Driadix/ShuttleController/docs/ControllerV6/ControllerV6.kicad_pcb

## KiCad design docs/ControllerV6/ControllerV6.kicad_pcb (2026-07-10)

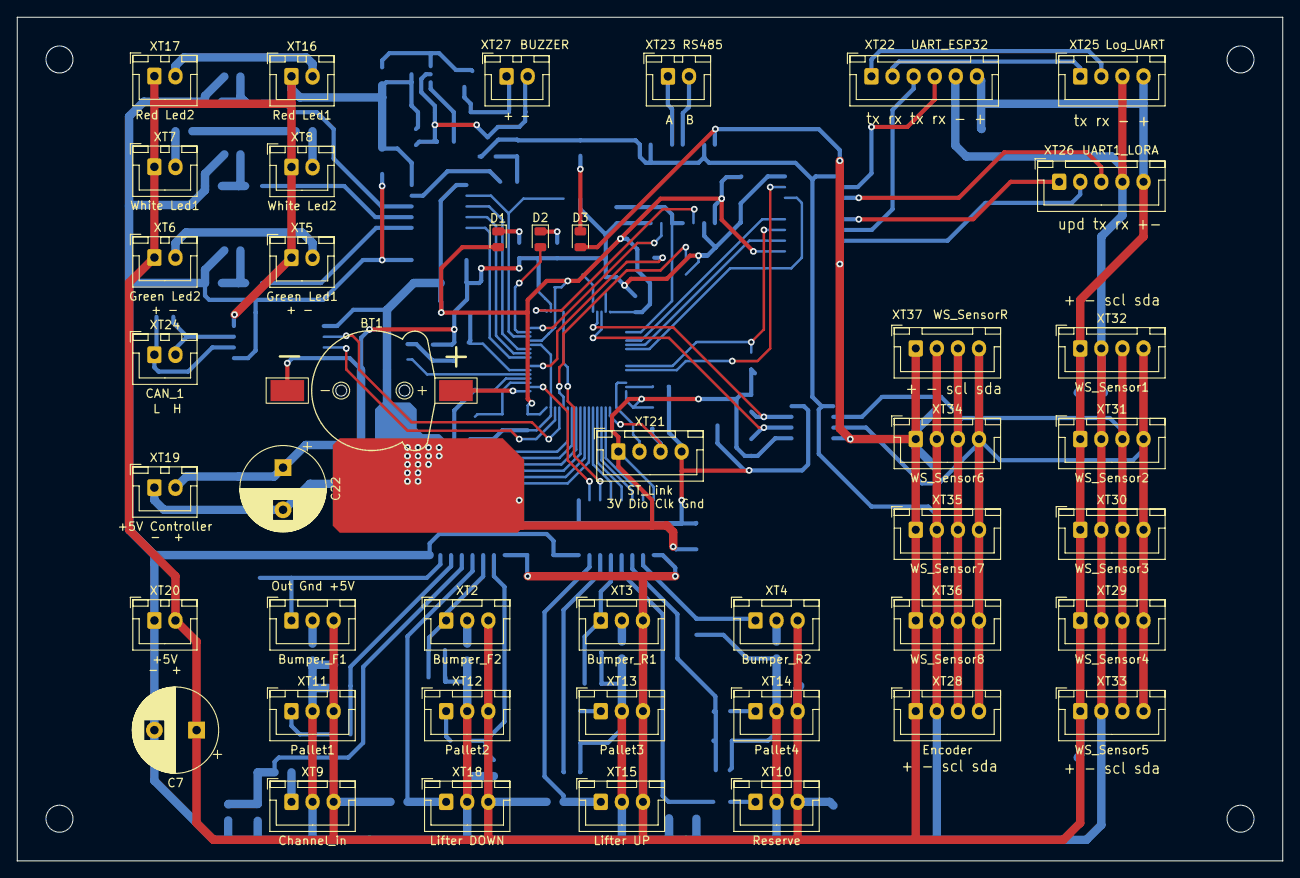
[picture p1: board ControllerV6.kicad_pcb from above]

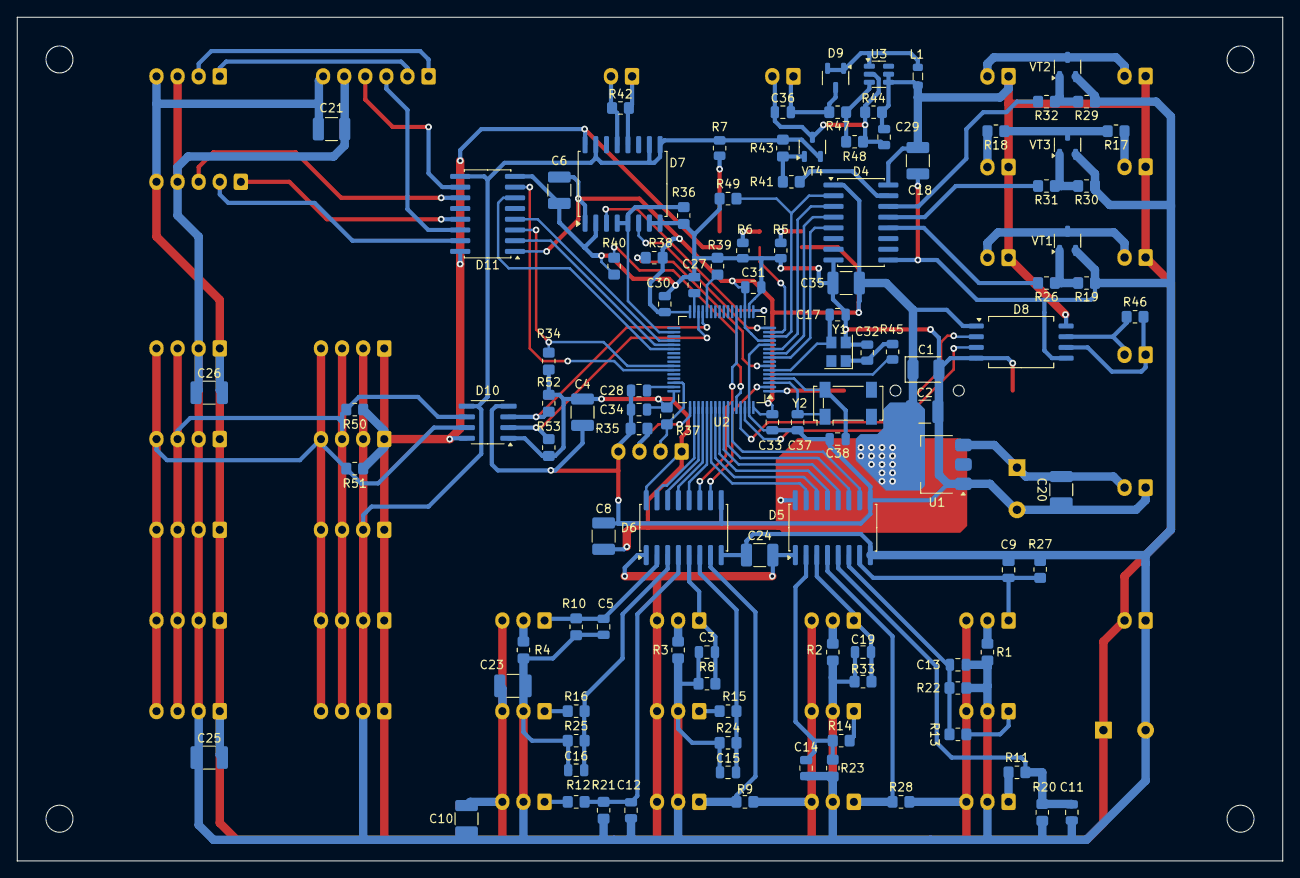
[picture p2: board ControllerV6.kicad_pcb from below]

Board: 2 copper layers, 150.0 x 100.0 mm, 150 parts (107 on the bottom side), 102 nets.

Parts:
BT1: +3V; BatteryHolder_RUICHI_856_CR1220
C1: 47u; CP_EIA-3528-21_Kemet-B
C2, C4, C6, C8, C10, C17, C18, C20, C21, C23, C24, C25, C26: 22u; C_1210_3225Metric_Pad1.33x2.70mm_HandSolder
C3, C5, C9, C11, C12, C13, C14, C15, C16, C19, C30, C31, C33, C34: 100n; C_0805_2012Metric
C7, C22: 100u; CP_Radial_D10.0mm_P5.00mm
C27, C28, C29, C36: 2.2u; C_0805_2012Metric
C32, C35: 18pF; C_0805_2012Metric
C37, C38: 12pF; C_0805_2012Metric
D1, D3: LED_VDD; LED_0805_2012Metric
D2: LED_USER; LED_0805_2012Metric
D4, D11: CA-IS3762; SOIC-16W_5.3x10.2mm_P1.27mm
D5, D6: CA-IS3760; SOIC-16W_5.3x10.2mm_P1.27mm
D7: CA-IS3082; SOIC-16W_7.5x10.3mm_P1.27mm
D8: CA-IS3050G; SOIC-8_7.5x5.85mm_P1.27mm
D9: BAT54CW; SOT-23-3
D10: CA-IS3020S; SOIC-8_3.9x4.9mm_P1.27mm
L1: 4.7U; L_0805_2012Metric
R1, R2, R3, R4, R17, R18: 200; R_0805_2012Metric_Pad1.20x1.40mm_HandSolder
R5, R6, R7: 1.2K; R_0805_2012Metric
R8, R10, R27, R33, R34, R44, R47: 20k; R_0805_2012Metric_Pad1.20x1.40mm_HandSolder
R9, R28, R35, R36, R37, R38, R39, R40, R49, R52, R53: 6.8k; R_0805_2012Metric_Pad1.20x1.40mm_HandSolder
R11, R12, R13, R14, R15, R16: 1k; R_0805_2012Metric_Pad1.20x1.40mm_HandSolder
R19, R29, R30, R43: 360; R_0805_2012Metric_Pad1.20x1.40mm_HandSolder
R20, R21, R22, R23, R24, R25, R50, R51: 3k; R_0805_2012Metric_Pad1.20x1.40mm_HandSolder
R26, R31, R32, R41: 1.2k; R_0805_2012Metric_Pad1.20x1.40mm_HandSolder
R42, R46: 120; R_0805_2012Metric_Pad1.20x1.40mm_HandSolder
R45: 360; R_0805_2012Metric
R48: 1.5k; R_0805_2012Metric_Pad1.20x1.40mm_HandSolder
U1: AMS1117-3.3; SOT-223-3_TabPin2
U2: STM32F405RGTx; LQFP-64_10x10mm_P0.5mm
U3: MT3608; SOT-23-6
VT1, VT2, VT3, VT4: BC817; SOT-23-3
XT1: Bumper_F1; JST_XH_B3B-XH-A_1x03_P2.50mm_Vertical
XT2: Bumper_F2; JST_XH_B3B-XH-A_1x03_P2.50mm_Vertical
XT3: Bumper_R1; JST_XH_B3B-XH-A_1x03_P2.50mm_Vertical
XT4: Bumper_R2; JST_XH_B3B-XH-A_1x03_P2.50mm_Vertical
XT5: Green Led1; JST_XH_B2B-XH-A_1x02_P2.50mm_Vertical
XT6: Green Led2; JST_XH_B2B-XH-A_1x02_P2.50mm_Vertical
XT7: White Led1; JST_XH_B2B-XH-A_1x02_P2.50mm_Vertical
XT8: White Led2; JST_XH_B2B-XH-A_1x02_P2.50mm_Vertical
XT9: Channel_in; JST_XH_B3B-XH-A_1x03_P2.50mm_Vertical
XT10: Reserve; JST_XH_B3B-XH-A_1x03_P2.50mm_Vertical
XT11: Pallet1; JST_XH_B3B-XH-A_1x03_P2.50mm_Vertical
XT12: Pallet2; JST_XH_B3B-XH-A_1x03_P2.50mm_Vertical
XT13: Pallet3; JST_XH_B3B-XH-A_1x03_P2.50mm_Vertical
XT14: Pallet4; JST_XH_B3B-XH-A_1x03_P2.50mm_Vertical
XT15: Lifter UP; JST_XH_B3B-XH-A_1x03_P2.50mm_Vertical
XT16: Red Led1; JST_XH_B2B-XH-A_1x02_P2.50mm_Vertical
XT17: Red Led2; JST_XH_B2B-XH-A_1x02_P2.50mm_Vertical
XT18: Lifter DOWN; JST_XH_B3B-XH-A_1x03_P2.50mm_Vertical
XT19: +5V Controller; JST_XH_B2B-XH-A_1x02_P2.50mm_Vertical
XT20: +5V; JST_XH_B2B-XH-A_1x02_P2.50mm_Vertical
XT21: ST_Link; JST_XH_B4B-XH-A_1x04_P2.50mm_Vertical
XT22: UART_ESP32; JST_XH_B6B-XH-A_1x06_P2.50mm_Vertical
XT23: RS485; JST_XH_B2B-XH-A_1x02_P2.50mm_Vertical
XT24: CAN_1; JST_XH_B2B-XH-A_1x02_P2.50mm_Vertical
XT25: Log_UART; JST_XH_B4B-XH-A_1x04_P2.50mm_Vertical
XT26: UART1_LORA; JST_XH_B5B-XH-A_1x05_P2.50mm_Vertical
XT27: BUZZER; JST_XH_B2B-XH-A_1x02_P2.50mm_Vertical
XT28: Encoder; JST_XH_B4B-XH-A_1x04_P2.50mm_Vertical
XT29: WS_Sensor4; JST_XH_B4B-XH-A_1x04_P2.50mm_Vertical
XT30: WS_Sensor3; JST_XH_B4B-XH-A_1x04_P2.50mm_Vertical
XT31: WS_Sensor2; JST_XH_B4B-XH-A_1x04_P2.50mm_Vertical
XT32: WS_Sensor1; JST_XH_B4B-XH-A_1x04_P2.50mm_Vertical
XT33: WS_Sensor5; JST_XH_B4B-XH-A_1x04_P2.50mm_Vertical
XT34: WS_Sensor6; JST_XH_B4B-XH-A_1x04_P2.50mm_Vertical
XT35: WS_Sensor7; JST_XH_B4B-XH-A_1x04_P2.50mm_Vertical
XT36: WS_Sensor8; JST_XH_B4B-XH-A_1x04_P2.50mm_Vertical
XT37: WS_SensorR; JST_XH_B4B-XH-A_1x04_P2.50mm_Vertical
Y1: 8MHz; Crystal_SMD_3225-4Pin_3.2x2.5mm
Y2: 32.7KHz; Crystal_SMD_Abracon_ABS25-4Pin_8.0x3.8mm

Connections:
3.3V_1: C1.1, C2.2, C4.2, C6.2, C8.2, C17.2, C30.2, C31.2, C33.2, C34.2, D1.2 (A), D4.1 (VDA), D5.16 (VDDB), D6.16 (VDDB), D7.1 (VDDA), D8.1 (Vcc1), D10.1 (VDDA), D11.1 (VDA), R34.2, R37.1, R38.1, R52.2, R53.2, U1.2 (VO), U2.13 (VDDA), U2.19 (VDD), U2.32 (VDD), U2.48 (VDD), U2.64 (VDD), XT21.1
5V: C7.1, C10.1, C18.1, C21.2, C23.2, C24.2, C25.2, C26.2, C29.2, D3.2 (A), D4.16 (VDDB), D5.1 (VDA), D6.1 (VDA), D7.16 (VDDB), D8.8 (Vcc2), D10.8 (VDDB), D11.16 (VDDB), L1.1, R9.1, R28.2, R44.2, R50.2, R51.2, U3.4 (EN), U3.5 (IN), XT1.3, XT2.3, XT3.3, XT4.3, XT5.1, XT6.1, XT7.1, XT8.1, XT9.3, XT10.3, XT11.3, XT12.3, XT13.3, XT14.3, XT15.3, XT16.1, XT17.1, XT18.3, XT20.2, XT22.6, XT25.4, XT26.5, XT28.1, XT29.1, XT30.1, XT31.1, XT32.1, XT33.1, XT34.1, XT35.1, XT36.1, XT37.1
5V_1: C20.2, C22.1, U1.3 (VI), XT19.2
Boot0_: R40.2, U2.60 (BOOT0)
Boot1: R39.2, U2.28 (PB2)
BumpF1_In: C9.2, D5.7 (VI6), R27.1, XT1.1
BumpF1_In_: D5.10 (VO6), U2.59 (PB7)
BumpF2_In: C19.2, D5.3 (VI2), R33.1, XT2.1
BumpF2_In_: D5.14 (VO2), U2.55 (PB3)
BumpR1_In: C3.2, D6.5 (VI4), R8.1, XT3.1
BumpR1_In_: D6.12 (VO4), U2.53 (PC12)
BumpR2_In: C5.2, D6.2 (VI1), R10.1, XT4.1
BumpR2_In_: D6.15 (VO1), U2.50 (PA15)
Buzzer: D4.15 (VO1), R41.1
Buzzer_: D4.2 (VI1), R49.2, U2.14 (PA0)
Can RX_: D8.2 (RXD), U2.61 (PB8)
Can TX_: D8.3 (TXD), U2.62 (PB9)
Can_H: D8.7 (CANH), R46.2, XT24.2
Can_L: D8.6 (CANL), R46.1, XT24.1
DI RS485: D7.6 (DI), U2.16 (PA2)
Esp32 RX: D11.10 (VI6), XT22.4
Esp32 RX_: D11.7 (VO6), U2.43 (PA10)
Esp32 TX: D11.14 (VO2), XT22.3
Esp32 TX_: D11.3 (VI2), R34.1, U2.42 (PA9)
GND: BT1.2 (-), C1.2, C2.1, C4.1, C6.1, C8.1, C17.1, C20.1, C22.2, C27.1, C28.1, C30.1, C31.1, C32.2, C33.1, C34.1, C35.2, C37.2, C38.2, D4.8 (GNDA), D5.9 (GNDB), D6.9 (GNDB), D7.2 (GNDA), D7.7 (GNDA), D7.8 (GNDA), D8.4 (GND1), D10.4 (GNDA), D11.8 (GNDA), R5.1, R6.1, R35.1, R36.1, R39.1, R40.1, R49.1, U1.1 (GND), U2.12 (VSSA), U2.18 (VSS), U2.63 (VSS), XT19.1, XT21.4, Y1.2, Y1.4
GNDREF: C3.1, C5.1, C7.2, C9.1, C10.2, C11.1, C12.1, C13.1, C14.1, C15.1, C16.1, C18.2, C19.1, C21.1, C23.1, C24.1, C25.1, C26.1, D4.9 (GNDB), D5.8 (GNDA), D6.8 (GNDA), D7.9 (GNDB), D7.10 (GNDB), D7.15 (GNDB), D8.5 (GND2), D10.5 (GNDB), D11.9 (GNDB), R1.1, R2.2, R3.1, R4.1, R7.1, R8.2, R10.2, R19.1, R20.2, R21.2, R22.2, R23.2, R24.2, R25.2, R27.2, R29.1, R30.1, R33.2, R43.2, VT1.2 (E), VT2.2 (E), VT3.2 (E), VT4.2 (E), XT9.2, XT10.2, XT11.2, XT12.2, XT13.2, XT14.2, XT15.2, XT18.2, XT20.1, XT22.5, XT25.3, XT26.4, XT28.2, XT29.2, XT30.2, XT31.2, XT32.2, XT33.2, XT34.2, XT35.2, XT36.2, XT37.2
Green Led: D4.12 (VO4), R26.2
Green Led_: D4.5 (VI4), U2.9 (PC1)
HSE1: R45.2, U2.5 (PH0)
HSE2: C35.1, U2.6 (PH1), Y1.3
In channel: C11.2, D5.5 (VI4), R11.2, R20.1
In channel_: D5.12 (VO4), U2.57 (PB5)
LSE1: C37.1, U2.3 (PC14), Y2.1
LSE2: C38.1, U2.4 (PC15), Y2.4
Led: D2.2 (A), U2.15 (PA1)
Lifter DOWN: D5.4 (VI3), R28.1, XT18.1
Lifter DOWN_: D5.13 (VO3), U2.56 (PB4)
Lifter UP: D6.7 (VI6), R9.2, XT15.1
Lifter UP_: D6.10 (VO6), U2.2 (PC13)
Lora_RX: D11.11 (VI5), XT26.3
Lora_RX_: D11.6 (VO5), U2.38 (PC7)
Lora_TX: D11.15 (VO1), XT26.2
Lora_TX_: D11.2 (VI1), U2.37 (PC6)
Lora_Upd: D11.13 (VO3), XT26.1
Lora_Upd_: D11.4 (VI3), U2.36 (PB15)
unnamed: C32.1, R45.1, Y1.1
unnamed: D1.1 (K), R5.2
unnamed: D2.1 (K), R6.2
unnamed: D3.1 (K), R7.2
unnamed: D7.12 (A), R42.2, XT23.1
unnamed: D7.13 (B), R42.1, XT23.2
unnamed: R47.1, R48.2, U3.3 (FB)
unnamed: C29.1, C36.1, R44.1, R48.1, U3.2 (GND), VT4.3 (C), XT27.2
unnamed: D9.1, D9.2, L1.2, U3.1 (SW)
unnamed: R19.2, R26.1, VT1.1 (B)
unnamed: VT1.3 (C), XT5.2, XT6.2
unnamed: R29.2, R32.1, VT2.1 (B)
unnamed: VT2.3 (C), XT16.2, XT17.2
unnamed: R30.2, R31.1, VT3.1 (B)
unnamed: R17.2, R18.1, VT3.3 (C)
unnamed: R41.2, R43.1, VT4.1 (B)
unnamed: R1.2, XT1.2
unnamed: R2.1, XT2.2
unnamed: R3.2, XT3.2
unnamed: R4.2, XT4.2
unnamed: R17.1, XT7.2
unnamed: R18.2, XT8.2
unnamed: R11.1, XT9.1
unnamed: R12.1, XT10.1
unnamed: R13.1, XT11.1
unnamed: R14.1, XT12.1
unnamed: R15.1, XT13.1
unnamed: R16.2, XT14.1
unnamed: XT22.1, XT25.2
unnamed: XT22.2, XT25.1
unnamed: C36.2, D9.3, R47.2, XT27.1
Pallet1: C13.2, D5.6 (VI5), R13.2, R22.1
Pallet1_: D5.11 (VO5), U2.58 (PB6)
Pallet2: C14.2, D5.2 (VI1), R14.2, R23.1
Pallet2_: D5.15 (VO1), U2.54 (PD2)
Pallet3: C15.2, D6.6 (VI5), R15.2, R24.1
Pallet3_: D6.11 (VO5), U2.21 (PA5)
Pallet4: C16.2, D6.3 (VI2), R16.1, R25.1
Pallet4_: D6.14 (VO2), U2.51 (PC10)
RE RS485: D7.4 (RE), D7.5 (DE), R36.2, U2.34 (PB13)
RO RS485: D7.3 (RO), U2.17 (PA3)
Red Led: D4.14 (VO2), R32.2
Red Led_: D4.3 (VI2), U2.11 (PC3)
Reserve: C12.2, D6.4 (VI3), R12.2, R21.1
Reserve_: D6.13 (VO3), U2.52 (PC11)
Reset_: R38.2, U2.7 (NRST)
SCL: D10.6 (SCLB), R50.1, XT28.3, XT29.3, XT30.3, XT31.3, XT32.3, XT33.3, XT34.3, XT35.3, XT36.3, XT37.3
SCL_: D10.3 (SCLA), R52.1, U2.29 (PB10)
SDA: D10.7 (SDAB), R51.1, XT28.4, XT29.4, XT30.4, XT31.4, XT32.4, XT33.4, XT34.4, XT35.4, XT36.4, XT37.4
SDA_: D10.2 (SDAA), R53.1, U2.30 (PB11)
SWCLK: R35.2, U2.49 (PA14), XT21.3
SWDIO: R37.2, U2.46 (PA13), XT21.2
VCAP_1: C27.2, U2.31 (VCAP_1)
VCAP_2: C28.2, U2.47 (VCAP_2)
Vbat: BT1.1 (+), U2.1 (VBAT)
White Led: D4.13 (VO3), R31.2
White Led_: D4.4 (VI3), U2.10 (PC2)
