Driadix/ShuttleController/Cntrl_V2/Cntrl_V2.ino

#include "As5600Sensor.h"
#include "AlertManager.h"
#include "BmsDdA5FirmwareAdapter.hpp"
#include "E22Radio.hpp"
#include "STM32TimerInterrupt.h"
#include "STM32_CAN.h"
#include "ShuttleProtocol.h"
#include "TOF_Sense.h"
#include "TofBusMonitor.h"
#include "TofHealthMonitor.h"
#include <IWatchdog.h>
#include <STM32RTC.h>
#include <String.h>
#include <Wire.h>

#pragma region Макросы...
#if defined(__GNUC__)
#pragma GCC diagnostic ignored "-Wunknown-pragmas"
#endif

#ifndef CONNECTION_LOGS
#define CONNECTION_LOGS 0
#endif

#ifndef I2C_DIAG_LOGS
#define I2C_DIAG_LOGS 0
#endif

constexpr size_t LOG_FORMAT_MAX_PRINTABLE_CHARS = 255;

enum BreadcrumbStage : uint8_t
{
    BC_BOOT = 1,
    BC_LOOP,
    BC_SYSTEM_YIELD,
    BC_BMS_TICK,
    BC_TX_TELEMETRY,
    BC_TX_SENSORS,
    BC_TX_STATS,
    BC_TX_LINK_HEALTH,
    BC_POLL_DISPLAY,
    BC_POLL_RADIO,
    BC_TOF_POLL,
    BC_TOF_PREFLIGHT,
    BC_TOF_PROBE,
    BC_TOF_READ,
    BC_TOF_RECOVERY,
    BC_AS5600_ANGLE,
    BC_SERIAL_COMMAND
};

#pragma pack(push, 1)
struct BreadcrumbRecord
{
    uint32_t magicWord;
    uint32_t sequence;
    uint32_t millisAt;
    uint8_t  stage;
    uint8_t  sensor;
    uint8_t  status;
    uint8_t  detail;
    uint16_t crc16;
    uint16_t reserved;
};
#pragma pack(pop)

#if CONNECTION_LOGS
#define DIAG_ONLY(code)                                                                                                     \
    do                                                                                                                      \
    {                                                                                                                       \
        code;                                                                                                               \
    } while (0)
#else
#define DIAG_ONLY(code)                                                                                                     \
    do                                                                                                                      \
    {                                                                                                                       \
    } while (0)
#endif

#define LOG_RATE_LIMITED(level, interval, format, ...)                                                                      \
    do                                                                                                                      \
    {                                                                                                                       \
        static_assert(                                                                                                      \
            sizeof(format) - 1 <= LOG_FORMAT_MAX_PRINTABLE_CHARS,                                                           \
            "Log format string too long for logStringBuffer.");                                                             \
        static uint32_t lastLog = 0;                                                                                        \
        if (millis() - lastLog > (interval))                                                                                \
        {                                                                                                                   \
            makeLogImpl(level, format, ##__VA_ARGS__);                                                                      \
            lastLog = millis();                                                                                             \
        }                                                                                                                   \
    } while (0)

#define makeLog(level, format, ...)                                                                                         \
    do                                                                                                                      \
    {                                                                                                                       \
        static_assert(                                                                                                      \
            sizeof(format) - 1 <= LOG_FORMAT_MAX_PRINTABLE_CHARS,                                                           \
            "makeLog: format string literal exceeds logStringBuffer capacity.");                                             \
        makeLogImpl(level, format, ##__VA_ARGS__);                                                                          \
    } while (0)

#define makeReliableLog(level, format, ...)                                                                                 \
    do                                                                                                                      \
    {                                                                                                                       \
        static_assert(                                                                                                      \
            sizeof(format) - 1 <= LOG_FORMAT_MAX_PRINTABLE_CHARS,                                                           \
            "makeReliableLog: format string literal exceeds logStringBuffer capacity.");                                     \
        makeReliableLogImpl(level, format, ##__VA_ARGS__);                                                                  \
    } while (0)

void                           makeLogImpl(LogLevel level, const char *format, ...);
void                           makeReliableLogImpl(LogLevel level, const char *format, ...);
void                           makeBootLog(LogLevel level, const char *format, ...);
static const char             *breadcrumbStageName(uint8_t stage);
static bool                    readBreadcrumb(BreadcrumbRecord *out);
static void                    writeBreadcrumb(BreadcrumbStage stage, uint8_t sensor = 0xFF, uint8_t status = 0, uint8_t detail = 0);
static void                    logPreviousBreadcrumbIfWatchdog(uint32_t resetFlags);
static void                    logBreadcrumbSummaryIfDue(uint32_t now);
static inline bool             isValidProvisionedShuttleId(int32_t id);
static inline bool             isProvisionedShuttle();
static inline bool             isSupportedCommand(uint8_t cmd);
static inline bool             isManualMoveCommand(uint8_t cmd);
static inline bool             isManualDistanceCommand(uint8_t cmd);
static inline bool             isContinuousManualCommand(uint8_t cmd);
static inline bool             isLiftCommand(uint8_t cmd);
static inline bool             isUnprovisionedCommandAllowed(uint8_t cmd);
static inline bool             isOutOfChannelExemptCommand(uint8_t cmd);
static inline bool             canAcceptCommandNow(uint8_t cmd, bool fromRadio);
static inline bool             canApplyConfigNow();
static inline bool             isPhysicallyStationary();
static inline void             performSystemReset();
static inline void             clearLatchedAlertsAndReturnToIdle(uint32_t now);
static inline void             resetTofDiagnostics();
static inline void             handlePendingCrash();
static void                    crashF1Irq();
static void                    crashF2Irq();
static void                    crashR1Irq();
static void                    crashR2Irq();
static void                    recordBootResetCause();
static void                    setResetRequestMarker(uint32_t flags);
static uint32_t                consumeResetRequestMarker();
static uint32_t                captureResetReasonFlags();
static const char             *primaryResetCategoryName(uint32_t flags);
static inline void             touchManualSession();
static inline void             beginManualRadioHold(uint32_t now);
static inline void             refreshManualRadioHoldWatchdog(uint32_t now);
static inline void             clearManualRadioHold();
static void                    scheduleBootloaderEntry();
static void                    enableBackupSramAccess(uint32_t readyTimeoutMs);
static bool                    consumeBootloaderResetRequest();
static void                    requestBootloaderResetEntry();
static void                    resetIntoBootloader();
static E22Radio::EnsureOptions makeRadioEnsureOptions();
static E22Radio::LogicalConfig makeRadioDesiredConfig(uint8_t nodeId);
static bool                    ensureRadioConfigNow(const char *reason);
enum class RadioTxAuxPolicy : uint8_t
{
    DropIfBusy,
    SendAfterTimeout
};
static void       reapplyRadioConfigForShuttleId(uint8_t newId, uint8_t previousId);
static inline int transportAvailableForWrite(Stream *port);
static size_t
writeTransportPayload(
    Stream *port,
    const uint8_t *buffer,
    uint16_t length,
    const E22Radio::FixedRoute *fixedRoute = NULL,
    RadioTxAuxPolicy auxPolicy = RadioTxAuxPolicy::DropIfBusy);
static ShuttleState predictTelemetryStateForAcceptedCommand(uint8_t cmd, bool fromRadio);
static void         populateTelemetryPacket(TelemetryPacket *pkt, int16_t shuttleStatusOverride = -1);
static void         sendAck(uint8_t seq, AckResult result, Stream *port, const E22Radio::FixedRoute *fixedRoute = NULL);
static void         sendTelemAck(
            uint8_t                     seq,
            AckResult                   result,
            Stream                     *port,
            int16_t                     shuttleStatusOverride = -1,
            const E22Radio::FixedRoute *fixedRoute            = NULL);
static void sendCommandAck(
    uint8_t   seq,
    AckResult result,
    Stream   *port,
    bool      suppressAck,
    bool      useTelemAck,
    int16_t   shuttleStatusOverride = -1);
static void                  sendTelemetryPacket(Stream *port);
static void                  sendSensorPacket(Stream *port);
static void                  sendStatsPacket(Stream *port);
static void                  sendLinkHealthPacket(Stream *port);
static void                  populateLinkHealthPacket(LinkHealthPacket *pkt);
static void                  sendAs5600HealthPacket(Stream *port);
static bool                  isRadioPacketRssiFresh(uint32_t now);
static BmsDdA5::ActivityHint mapBatteryActivity();
static void                  batterySafetyCheck(uint32_t now);
static void                  batterySafetyReset(uint32_t now);
static void                  stopTofI2cBus();
static void                  initTofI2cBus();
static bool                  performTofSdaClockRecovery(const char *reason);
static bool                  performTofSclReleaseRecovery(const char *reason);
static bool                  performTofWireReinit(const char *reason);
static bool                  recoverTofBusForManualClear();
static bool                  serviceTofBusMonitor(uint32_t now);
static inline bool           tofBusLinesHighNow();
static void                  resetTofBusVote();
static void                  beginTofSchedulerPause(uint32_t now);
static void                  endTofSchedulerPause(uint32_t now, const char *reason);
static void                  setTofI2cClock(uint32_t clockHz);
static uint8_t               i2cProbeAddress(uint8_t address);
static uint8_t               scanTofAddressMask();
static void                  logI2cBootScanAtClock(uint32_t clockHz);
static void                  logTofI2cLines(const char *tag);
static void                  logI2cBootScan();
static void                  logTofBootSnapshot();
static void                  logI2cDiagSummaryIfDue(uint32_t now);
static bool                  ensureAs5600BusReady(uint32_t now);
static void                  serviceAs5600Safety(uint32_t now);
static void                  logAs5600FailureIfDue(uint32_t now);
static void                  latchAs5600Fault(const char *context, uint8_t i2cStatus);
static void                  clearRecoveredAs5600FaultIfSafe(uint32_t now);
static bool                  readAs5600AngleForMotion(uint16_t *rawAngle);
static bool                  readAs5600AngleFresh(int *angleOut);
static void                  logBootResetReplay();
static void                  retryRadioConfigIfIdle(uint32_t now);
static inline bool           batteryIsHighLoad();
static inline bool           batteryLowFaultLatched();
static bool                  batteryIsMotionLikeStatus(uint8_t st);
static const char           *tofNameForSensor(uint8_t sensorIndex);
static uint8_t               tofSensorForDistanceSlot(uint8_t distanceSlot);
static void                  latchTofMeasurementFault(uint8_t sensor, uint32_t now, const char *context);
static bool                  ensureChannelTofReadyForMotion(bool forward, const char *context);
static void                  enforceActiveMotionTofSafety(uint32_t now);

static inline void preserveManualStopOnAbort();
static inline bool shouldAbortLoop();
static inline bool isErrorActive();
static inline bool isOverrideCommand(uint8_t cmd);
static inline void countTxFrame(Stream *port);
static inline void countReplyTiming(Stream *port, uint32_t elapsedUs);
static inline bool isShuttleIdle();

void motor_Stop();
void motor_Force_Stop();
void motor_Speed(int spd);
void moove_Before_Pallete_F();
void moove_Before_Pallete_R();
void stop_Before_Pallete_F();
void stop_Before_Pallete_R();
void moove_Distance_F(int dist, int maxSpeed, int minSpeed);
void moove_Distance_F(int dist);
void moove_Distance_R(int dist, int maxSpeed, int minSpeed);
void moove_Distance_R(int dist);
void moove_Forward();
void moove_Reverse();
void moove_Right();
void moove_Left();

// Operations
void lifter_Down();
void lifter_Up();
void lifter_Stop();
void load_Pallete();
void unload_Pallete();
void single_Load();
void long_Load();
void long_Unload();
void long_Unload(uint8_t num);
void pallete_Compacting_F();
void pallete_Compacting_R();
void pallete_Counting_F();
void demo_Mode();

// System
void run_Cmd();
void send_Cmd();
void get_Distance();
void detect_Pallete();
void set_Position();
void blink_Work();
void blink_Warning();
void blink_Error();
void jumpToBootloader();

#define STATS_MAGIC_WORD        0xAA55BEF0
#define BKPSRAM_BASE_ADDR       0x40024000
#define RESET_MARKER_MAGIC_WORD 0x51E7A5E7UL
#define RESET_MARKER_MAGIC_ADDR (BKPSRAM_BASE_ADDR + 0x0FE8)
#define RESET_MARKER_FLAGS_ADDR (BKPSRAM_BASE_ADDR + 0x0FEC)
#define BOOTLOADER_MAGIC_WORD 0xB00710ADUL
#define BOOTLOADER_MAGIC_ADDR (BKPSRAM_BASE_ADDR + 0x0FF0)
#define BOOTLOADER_MAGIC_CONFIRM_WORD 0x4FF8EF52UL
#define BOOTLOADER_MAGIC_CONFIRM_ADDR (BKPSRAM_BASE_ADDR + 0x0FF4)
#define DIAG_BREADCRUMB_MAGIC_WORD 0xBADC0DE5UL
#define DIAG_BREADCRUMB_OFFSET     0x0F80
#define DIAG_BREADCRUMB_ADDR       (BKPSRAM_BASE_ADDR + DIAG_BREADCRUMB_OFFSET)
#define DIAG_BREADCRUMB_MAX_AGE_MS 600000UL

#pragma pack(push, 1)
struct SecureStats
{
    uint32_t    magicWord;
    StatsPacket payload;
    uint16_t    crc16;
    uint16_t    reserved;
};
#pragma pack(pop)

static_assert(sizeof(SecureStats) <= DIAG_BREADCRUMB_OFFSET, "SecureStats overlaps diagnostic breadcrumb.");
static_assert(
    DIAG_BREADCRUMB_OFFSET + sizeof(BreadcrumbRecord) <= 0x0FE8,
    "Diagnostic breadcrumb overlaps reset markers.");

SecureStats *volatile sramStats = (SecureStats *)BKPSRAM_BASE_ADDR;
static volatile uint32_t *const resetMarkerMagic = (volatile uint32_t *)RESET_MARKER_MAGIC_ADDR;
static volatile uint32_t *const resetMarkerFlags = (volatile uint32_t *)RESET_MARKER_FLAGS_ADDR;
static volatile uint32_t *const bootloaderMagicWord = (volatile uint32_t *)BOOTLOADER_MAGIC_ADDR;
static volatile uint32_t *const bootloaderMagicConfirm = (volatile uint32_t *)BOOTLOADER_MAGIC_CONFIRM_ADDR;
static volatile BreadcrumbRecord *const diagBreadcrumb = (volatile BreadcrumbRecord *)DIAG_BREADCRUMB_ADDR;
static uint32_t breadcrumbSequence = 0;
static uint32_t lastBootResetFlags = RESET_REASON_UNKNOWN;
static uint32_t lastBootResetMarkerFlags = RESET_REASON_NONE;

ProtocolParser               parserRadio;
ProtocolParser               parserDisplay;
E22Radio::Radio              e22Radio;
constexpr E22Radio::UartBaud kRadioHostBaud = E22Radio::UartBaud::B57600;

#define STATS_ATOMIC_UPDATE(action)                                                                                         \
    do                                                                                                                      \
    {                                                                                                                       \
        __disable_irq();                                                                                                    \
        action;                                                                                                             \
        sramStats->crc16 = ProtocolUtils::calcCRC16((uint8_t *)&sramStats->payload, sizeof(StatsPacket));                   \
        __enable_irq();                                                                                                     \
    } while (0)

#define CONFIG_SECTOR      FLASH_SECTOR_7
#define CONFIG_SECTOR_BASE 0x08060000
#define CONFIG_SECTOR_SIZE (128 * 1024)
#define CONFIG_PAGE_SIZE   512
#define CONFIG_TOTAL_PAGES (CONFIG_SECTOR_SIZE / CONFIG_PAGE_SIZE)

struct ConfigPageHeader
{
    uint8_t  state;
    uint8_t  reserved[1];
    uint16_t crc16;
};
#define MEDIAN(a, b, c) ((a) + (b) + (c) - min(min(a, b), c) - max(max(a, b), c))

#pragma endregion

#pragma region Пины и дефайны...

#define DL_UP       PC13 // Пин датчика положения лифтера в поднятом состоянии
#define DL_DOWN     PB4  // Пин датчика положения лифтера в опущенном состоянии
#define DATCHIK_F1  PA5  // Пин датчика 1 обнаружения паллета вперед
#define DATCHIK_F2  PC4  // Пин датчика 2 обнаружения паллета вперед
#define DATCHIK_R1  PB6  // Пин датчика 1 обнаружения паллета назад
#define DATCHIK_R2  PD2  // Пин датчика 2 обнаружения паллета назад
#define GREEN_LED   PC1  // Пин зеленого светодиода
#define BOARD_LED   PA1  // Пин светодиода на плате
#define RED_LED     PC3  // Пин красного светодиода ошибки
#define WHITE_LED   PC2  // Пин белого светодиода работы
#define ZOOMER      PA0  // Зумер
#define RADIO_E22_M0  PB15
#define RADIO_E22_M1  PB14
#define RADIO_E22_AUX PC0
#define RS485       PB13 // Пин передачи шины RS485
#define BUMPER_F1   PB7  // Пин бампера вперед
#define BUMPER_F2   PB3  // Пин бампера вперед
#define BUMPER_R1   PC12  // Пин бампера назад
#define BUMPER_R2   PA15  // Пин бампера назад
#define CHANNEL     PB5  // Пин датчика канала
#define TOF_I2C_SDA PB11
#define TOF_I2C_SCL PB10

#define FLASH_SECTOR_SIZE  4 * 1024 // 16 kb
#define EEPROM_PAGE_SIZE   512
#define EEPROM_TOTAL_PAGES FLASH_SECTOR_SIZE / EEPROM_PAGE_SIZE
#define EEPROM_HEADER_SIZE 1
#define EEPROM_DATA_SIZE   EEPROM_PAGE_SIZE - EEPROM_HEADER_SIZE

#define SerialLora    Serial3
#define SerialRS485   Serial2
#define SerialDisplay Serial1

constexpr uint8_t  NO_NEW_CMD                  = 0xFF;
constexpr uint8_t  kFirmwareVersionMajor       = 2;
constexpr uint8_t  kFirmwareVersionMinor       = 0;
constexpr uint8_t  kFirmwareVersionPatch       = 7;
constexpr uint32_t kBootLogSettleMs            = 250;
constexpr uint32_t kBootLogWriteTimeoutMs      = 250;
constexpr uint32_t kManualSessionIdleTimeoutMs = 60000;
constexpr uint32_t kManualRadioHoldWatchdogMs  = 3000;
constexpr uint32_t tofI2cClockHz                = 100000U;
constexpr uint32_t kTofI2cSlowProbeClockHz      = 100000U;
constexpr uint32_t kTofI2cFastProbeClockHz      = 400000U;
constexpr uint32_t kTofI2cRecoveryMinIntervalMs      = 5000U;
constexpr uint32_t kTofLineLowConfirmMs               = 2U;
constexpr uint32_t kTofLineReleaseConfirmMs           = 2U;
constexpr uint32_t kTofFailureLogIntervalMs           = 5000U;
constexpr uint32_t kBmsTofQuietGuardMs                = 5U;
constexpr uint32_t kRadioPacketRssiFreshMs            = 10000UL;
constexpr uint32_t kLinkHealthPublishMs               = 5000UL;
constexpr uint32_t kRadioRuntimeAuxWaitMs             = 20UL;
constexpr uint32_t kRadioLinkSilenceProbeMs           = 15000UL;
constexpr uint32_t kRadioPresenceAuditIntervalMs      = 300000UL;
constexpr uint32_t kRadioProbeRxQuietMs               = 10000UL;
constexpr uint32_t kI2cDiagSummaryIntervalMs          = 30000UL;

#pragma endregion

#pragma region Переменные...

char logStringBuffer[256];

enum class CoreOpMode
{
    IDLE,
    AUTO_EXEC,
    MANUAL,
    ERROR
};
CoreOpMode currentMode                    = CoreOpMode::IDLE;
uint32_t   lastManualSessionActivityTime  = 0;
bool       pendingDisplayManualModeBypass = false;
bool       manualRadioHoldActive          = false;
bool       statusSourceRadio              = false;
bool       radioAppendedRssiEnabled       = false;
bool       radioConfigOk                  = false;
uint32_t   manualRadioHoldLastHeartbeatMs = 0;
bool       serialLinksStarted             = false;
enum class RadioLocalState : uint8_t
{
    Unverified = 0,
    Ready,
    NoResponse,
    AuxTimeout,
    BadResponse,
    ConfigError
};
E22Radio::EnsureResult radioLastEnsureResult = {};
RadioLocalState         radioLocalState       = RadioLocalState::Unverified;
bool                    radioModuleResponded  = false;
uint8_t                 radioFailureStreak    = 0;
uint32_t                radioLastRxFrameMs    = 0;
uint32_t                radioLastLocalProbeMs = 0;
uint32_t                radioLastConfirmedMs  = 0;
uint32_t                radioRetryDelayMs     = 5000UL;

HardwareSerial Serial1(PA10, PA9); // Порт для экранцика LilyGo
HardwareSerial Serial2(PA3, PA2);  // Порт под RS485 для BMS батареи
HardwareSerial Serial3(PC7, PC6);  // Порт Lora
static const E22Radio::ControlPins kRadioControlPins = { RADIO_E22_M0, RADIO_E22_M1, RADIO_E22_AUX };

STM32_CAN            Can1(CAN1, ALT, RX_SIZE_256, TX_SIZE_256); // CAN шина на пинах PB8 PB9
static CAN_message_t CAN_TX_msg;                                // Пакет данных CAN на передачу
static CAN_message_t CAN_RX_msg;                                // Пакет данных CAN на прием

STM32Timer ITimer0(TIM1); // Таймер для прерываний

STM32RTC &rtc = STM32RTC::getInstance(); // Часы реального времени

typedef union
{
    int     vint;
    uint8_t bint[4];
} cracked_int_t; // Структура конвертации типа float в массив байтов для отправки по CAN

typedef union
{
    float   v;
    uint8_t b[4];
} cracked_float_t; // Структура конвертации типа float в массив байтов для отправки по CAN

#pragma pack(push, 1)
struct EEPROMData // Структура данных параметров для сохранения а EEProm
{
    uint8_t  shuttleNum;
    uint8_t  calibrateEncoder_F[8];
    uint8_t  calibrateEncoder_R[8];
    uint8_t  calibrateSensor_F[3];
    uint8_t  calibrateSensor_R[3];
    int      blinkTime;
    uint16_t maxSpeed;
    uint16_t minSpeed;
    uint16_t interPalleteDistance;
    uint8_t  inverse;
    uint8_t  fifoLifo;
    int      lifter_Speed;
    uint32_t timingBudget;
    uint8_t  minBattCharge;
    uint16_t shuttleLength;
    int      waitTime;
    int8_t   mprOffset;
    uint8_t  TopLeftXF;
    uint8_t  TopLeftYF;
    uint8_t  BotRightXF;
    uint8_t  BotRightYF;
    uint8_t  TopLeftXR;
    uint8_t  TopLeftYR;
    uint8_t  BotRightXR;
    uint8_t  BotRightYR;
    int8_t   chnlOffset;
};
#pragma pack(pop)

EEPROMData eepromData;

volatile bool      pendingEepromSave       = false;
constexpr uint32_t kBootloaderEntryGraceMs = 15;
constexpr uint32_t kSystemBootloaderAddr   = 0x1FFF0000UL;
volatile bool      pendingBootloaderEntry  = false;
volatile bool      bootloaderStopDone      = false;
volatile uint32_t  bootloaderEntryAtMs     = 0;

AlertManager alertMan;

#if CONNECTION_LOGS
struct LinkDiagCounters
{
    uint32_t radioRxValid;
    uint32_t radioRxCrcFail;
    uint32_t radioRxDropTarget;
    uint32_t radioTxFrames;
    uint32_t radioReplyCount;
    uint32_t radioReplyUsSum;
    uint32_t radioReplyUsMax;
    uint32_t displayRxValid;
    uint32_t displayRxCrcFail;
    uint32_t displayRxDropTarget;
    uint32_t displayTxFrames;
    uint32_t displayReplyCount;
    uint32_t displayReplyUsSum;
    uint32_t displayReplyUsMax;
    uint32_t loopJitterMaxMs;
    uint32_t loopGapOver20Ms;
};

LinkDiagCounters linkDiag            = {};
uint32_t         linkDiagLastYieldMs = 0;
#endif

void setFault(ShuttleFault fault)
{
    alertMan.setFault(fault);
}

void setWarning(ShuttleWarning warn, uint32_t timeoutMs = 5000)
{
    alertMan.setWarning(warn, timeoutMs, millis());
}

void clearWarning(ShuttleWarning warn)
{
    alertMan.clearWarning(warn);
}

void clearAllWarnings()
{
    alertMan.clearAllWarnings();
}

uint8_t      status           = 0; // Командный статус
ShuttleState currentOperation = STATE_IDLE;
uint8_t      shuttleNum       = 0; // Номер шаттла -сохранять-
uint8_t      channel[1024];        // Массив канала
uint8_t      calibrateEncoder_F[8] = {
    40, 40, 40, 40, 40, 40, 40, 40
}; // Массив данных калибровки магнитного энкодера при движении вперед -сохранять-
uint8_t calibrateEncoder_R[8] = {
    40, 40, 40, 40, 40, 40, 40, 40
}; // Массив данных калибровки магнитного энкодера при движении вперед -сохранять-
uint8_t calibrateSensor_F[3] = { 100, 100, 100 }; // Массив калибровки канального сенсора расстояния вперед -сохранять-
uint8_t calibrateSensor_R[3] = { 100, 100, 100 }; // Массив калибровки канального сенсора расстояния назад -сохранять-

uint8_t  counter              = 0;        // Счетчик для красивых морганий в рабочем режиме
uint8_t  debuger              = 0;        // Счетчик для дебагера
uint8_t  sensorOff            = 0;        // Флаг отключения сенсоров в ручном режиме
uint8_t  lastPallete          = 0;        // Флаг позиции последнего паллета
uint8_t  minBattCharge        = 20;       // Минимальный заряд батареи
uint8_t  endOfChannel         = 0;        // Флаг концов канала
int      blinkTime            = 80;       // Время квантования красивых морганий -сохранять-
int      waitTime             = 15000;    // Время ожидания при выгрузке
int      count                = millis(); // Счетчик времени общего назначения
int      count2               = count;    // Счетчик времени общего назначения
int      countSensor          = count;    // Счетчик времени опроса датчиков
int      countMoove           = count;    // Счетчик времени обновления передачи скорости по Can шине
uint16_t speed                = 0;        // Скорость движения в канале в %
uint16_t maxSpeed             = 96;       // Максимальное значение скорости (от 0 до 100 %) -сохранять-
uint16_t minSpeed             = 3;        // Минимальное значение скорости (лаг для АЦП) -сохранять-
uint16_t oldSpeed             = 0;        // Запомненная cкорость движения в канале для плавного разгона и торможения
uint16_t distance[8]          = { 0 };    // Значения от сенсоров расстояния и датчиков положения
uint16_t palletePosition[16]  = { 0 };    // Массив расстояний до паллет в канале
uint16_t mooveDistance        = 0;    // Значение дистанции для перемещения шаттла по команде движения на заданное расстояние
uint16_t interPalleteDistance = 100;  // Значение дистанции между паллетами -сохранять-
uint16_t shuttleLength        = 1000; // Длинна шаттла (максимальная ширина паллета которые шаттл может перевозить)
uint8_t  detectPalleteF1;             // Флаг датчика обнаружения паллеты вперед 1
uint8_t  detectPalleteF2;             // Флаг датчика обнаружения паллеты вперед 2
uint8_t  detectPalleteR1;             // Флаг датчика обнаружения паллеты назад 1
uint8_t  detectPalleteR2;             // Флаг датчика обнаружения паллеты назад 2
uint8_t  palleteCount  = 0;           // Количество паллет
uint8_t  motorStart    = false;       // Флаг запуска двигателя движения
uint8_t  motorReverse  = 2;           // Флаг направления (0/1), 2 = остановлено
uint8_t  lifterUp      = 0;           // Флаг поднятой платформы
uint8_t  inverse       = 0;           // Флаг инверсии движения -сохранять-
uint8_t  longWork      = 0;           // Флаг продолжительной загрузки/выгрузки
uint8_t  reportCounter = 0;           // Счетчик паузы репортов в секундах
uint8_t  diffPallete   = 0;           // Смещение для паллеты
uint8_t  fifoLifo      = 0;           // Режим FIFO/LIFO -сохранять-
uint8_t  batteryCharge = 0;           // Заряд батареи
uint8_t  UPQuant       = 0;           // Количество паллет на выгрузку
uint8_t  load          = 0;           // Оценка массы нагрузки шаттла 0 - 100
uint8_t  mooveCount    = 0;           // Счетчик пробксовки при малой скорости
int8_t   mprOffset     = 0;           // Смещение значения МПР
int8_t   chnlOffset    = 0;           // Смещение в конце канала

struct BatterySafetyState
{
    bool     lowStopLatched           = false;
    bool     emergencyActionActive    = false;
    uint32_t requireFreshBasicAfterMs = 0;
};

static BmsDdA5::Config makeBatteryPollConfig()
{
    BmsDdA5::Config cfg;
    cfg.startupBasicRetryMs = 1000U;
    cfg.basicIdleMs       = 5000U;
    cfg.basicActiveMs     = 15000U;
    cfg.basicHighLoadMs   = 60000U;
    cfg.lowBatteryBasicMs = 5000U;
    cfg.cellIdleMs        = 60000U;
    cfg.deviceIdleMs      = 300000U;

    cfg.staleWarnMs = 300000U;
    return cfg;
}

static uint8_t  tofSensorErrors[4]          = { 0, 0, 0, 0 };
static uint8_t  tofReadErrors[4]            = { 0, 0, 0, 0 };
static uint8_t  tofTimeoutErrors[4]         = { 0, 0, 0, 0 };
static uint8_t  tofSharedBusErrors[4]       = { 0, 0, 0, 0 };
static uint8_t  tofLastDiagStatus[4]        = { TOF_I2C_OK, TOF_I2C_OK, TOF_I2C_OK, TOF_I2C_OK };
static uint32_t tofLastI2cRecoveryLogMs     = 0;
static bool     tofI2cRecoveryLogged        = false;
static uint32_t tofI2cRecoveryCount         = 0;
static uint32_t tofLastRecoverySummaryLogMs = 0;
static uint32_t tofLastI2cRecoveryAttemptMs = 0;
static bool     tofFailureWarnLogged[4]     = { false, false, false, false };
static bool     tofFaultLogged[4]           = { false, false, false, false };
static uint8_t  tofConsecutiveTransportFailures[4] = { 0, 0, 0, 0 };
static uint32_t tofLastFailureLogMs[4]       = { 0, 0, 0, 0 };
static bool     tofRuntimeStarted            = false;
static bool     tofSchedulerPaused           = false;
static uint32_t tofSchedulerPauseStartedMs    = 0U;
static uint8_t  tofBusVoteMask               = 0U;
static bool     tofBusVoteAs5600Failed       = false;
static TofHealthMonitor tofHealth[4];

static TofBusState tofBusState               = TofBusState::Ready;
static bool        tofWireActive              = false;
static uint32_t    tofLineLowSinceMs          = 0U;
static uint32_t    tofLinesHighSinceMs        = 0U;
static uint32_t    tofLastBusStateLogMs       = 0U;
static uint32_t    tofLastSclReleaseLogMs     = 0U;
static bool        tofSdaRecoveryAttempted    = false;

static As5600Sensor as5600Sensor(Wire, ensureAs5600BusReady);
static uint32_t     as5600LastReadFailLogMs = 0U;

constexpr uint8_t CRASH_SRC_F1 = 0x01;
constexpr uint8_t CRASH_SRC_F2 = 0x02;
constexpr uint8_t CRASH_SRC_R1 = 0x04;
constexpr uint8_t CRASH_SRC_R2 = 0x08;
volatile bool     crashPending = false;
volatile uint8_t  crashSourceMask = 0;
volatile uint16_t crashIrqCount = 0;
static uint32_t   crashLastLogMs = 0;

static const char *breadcrumbStageName(uint8_t stage)
{
    switch ((BreadcrumbStage)stage)
    {
    case BC_BOOT:
        return "boot";
    case BC_LOOP:
        return "loop";
    case BC_SYSTEM_YIELD:
        return "yield";
    case BC_BMS_TICK:
        return "bms";
    case BC_TX_TELEMETRY:
        return "tx_tel";
    case BC_TX_SENSORS:
        return "tx_sen";
    case BC_TX_STATS:
        return "tx_stat";
    case BC_TX_LINK_HEALTH:
        return "tx_link";
    case BC_POLL_DISPLAY:
        return "disp_rx";
    case BC_POLL_RADIO:
        return "rad_rx";
    case BC_TOF_POLL:
        return "tof_poll";
    case BC_TOF_PREFLIGHT:
        return "tof_pre";
    case BC_TOF_PROBE:
        return "tof_probe";
    case BC_TOF_READ:
        return "tof_read";
    case BC_TOF_RECOVERY:
        return "tof_rec";
    case BC_AS5600_ANGLE:
        return "as5600";
    case BC_SERIAL_COMMAND:
        return "cmd";
    default:
        return "unknown";
    }
}

static uint16_t breadcrumbCrc(const BreadcrumbRecord &record)
{
    BreadcrumbRecord crcRecord = record;
    crcRecord.magicWord        = 0;
    crcRecord.crc16            = 0;
    return ProtocolUtils::calcCRC16((uint8_t *)&crcRecord, sizeof(BreadcrumbRecord));
}

static bool readBreadcrumb(BreadcrumbRecord *out)
{
    if (out == nullptr)
    {
        return false;
    }

    BreadcrumbRecord local;
    local.magicWord = diagBreadcrumb->magicWord;
    local.sequence  = diagBreadcrumb->sequence;
    local.millisAt  = diagBreadcrumb->millisAt;
    local.stage     = diagBreadcrumb->stage;
    local.sensor    = diagBreadcrumb->sensor;
    local.status    = diagBreadcrumb->status;
    local.detail    = diagBreadcrumb->detail;
    local.crc16     = diagBreadcrumb->crc16;
    local.reserved  = diagBreadcrumb->reserved;

    if (local.magicWord != DIAG_BREADCRUMB_MAGIC_WORD)
    {
        return false;
    }
    if (breadcrumbCrc(local) != local.crc16)
    {
        return false;
    }

    *out = local;
    return true;
}

static void writeBreadcrumb(BreadcrumbStage stage, uint8_t sensor, uint8_t status, uint8_t detail)
{
    BreadcrumbRecord local = {};
    local.magicWord       = DIAG_BREADCRUMB_MAGIC_WORD;
    local.sequence        = ++breadcrumbSequence;
    local.millisAt        = millis();
    local.stage           = (uint8_t)stage;
    local.sensor          = sensor;
    local.status          = status;
    local.detail          = detail;
    local.crc16           = breadcrumbCrc(local);

    __disable_irq();
    diagBreadcrumb->magicWord = 0;
    diagBreadcrumb->sequence  = local.sequence;
    diagBreadcrumb->millisAt  = local.millisAt;
    diagBreadcrumb->stage     = local.stage;
    diagBreadcrumb->sensor    = local.sensor;
    diagBreadcrumb->status    = local.status;
    diagBreadcrumb->detail    = local.detail;
    diagBreadcrumb->crc16     = local.crc16;
    diagBreadcrumb->reserved  = 0;
    diagBreadcrumb->magicWord = local.magicWord;
    __enable_irq();
}

static void logPreviousBreadcrumbIfWatchdog(uint32_t resetFlags)
{
#if I2C_DIAG_LOGS
    if ((resetFlags & RESET_REASON_WATCHDOG) == 0)
    {
        return;
    }

    BreadcrumbRecord previous;
    if (!readBreadcrumb(&previous))
    {
        return;
    }

    if (previous.sequence > breadcrumbSequence)
    {
        breadcrumbSequence = previous.sequence;
    }

    makeReliableLog(
        LOG_WARN,
        "BC prev rst=%s bc=%s q=%lu ms=%lu s=%u st=%u d=%u c=%u",
        primaryResetCategoryName(resetFlags),
        breadcrumbStageName(previous.stage),
        (unsigned long)previous.sequence,
        (unsigned long)previous.millisAt,
        previous.sensor,
        previous.status,
        previous.detail,
        previous.crc16);
#else
    (void)resetFlags;
#endif
}

static void logBreadcrumbSummaryIfDue(uint32_t now)
{
#if I2C_DIAG_LOGS
    static uint32_t lastLogMs = 0;
    if (now - lastLogMs < 5000U)
    {
        return;
    }
    lastLogMs = now;

    BreadcrumbRecord current;
    if (!readBreadcrumb(&current))
    {
        return;
    }

    uint32_t age = (now >= current.millisAt) ? now - current.millisAt : DIAG_BREADCRUMB_MAX_AGE_MS;
    if (age > DIAG_BREADCRUMB_MAX_AGE_MS)
    {
        age = DIAG_BREADCRUMB_MAX_AGE_MS;
    }

    uint16_t timeoutTotal = 0;
    uint16_t busTotal     = 0;
    for (uint8_t i = 0; i < 4; ++i)
    {
        timeoutTotal += tofTimeoutErrors[i];
        busTotal += tofSharedBusErrors[i];
    }

    makeLog(
        LOG_DEBUG,
        "BC %s q=%lu age=%lu s=%u st=%u t=%u b=%u rec=%lu io=%u/%u",
        breadcrumbStageName(current.stage),
        (unsigned long)current.sequence,
        (unsigned long)age,
        current.sensor,
        current.status,
        timeoutTotal,
        busTotal,
        (unsigned long)tofI2cRecoveryCount,
        digitalRead(TOF_I2C_SDA),
        digitalRead(TOF_I2C_SCL));
#else
    (void)now;
#endif
}

static inline bool tofBusLinesHighNow()
{
    return digitalRead(TOF_I2C_SDA) == HIGH && digitalRead(TOF_I2C_SCL) == HIGH;
}

static void setTofI2cClock(uint32_t clockHz)
{
    Wire.setClock(clockHz);
    delayMicroseconds(50);
}

static uint8_t i2cProbeAddress(uint8_t address)
{
    if (!tofBusLinesHighNow())
    {
        return 0xFFU;
    }

    Wire.beginTransmission(address);
    return Wire.endTransmission();
}

static uint8_t scanTofAddressMask()
{
    uint8_t mask = 0;
    for (uint8_t id = 1U; id <= 4U; ++id)
    {
        if (i2cProbeAddress((uint8_t)(TOF_BASE_I2C_ADDR + id)) == 0U)
        {
            mask |= (uint8_t)(1U << (id - 1U));
        }
    }
    return mask;
}

static void logI2cBootScanAtClock(uint32_t clockHz)
{
    setTofI2cClock(clockHz);
    if (!tofBusLinesHighNow())
    {
        makeReliableLog(
            LOG_WARN,
            "I2C scan skip clk=%lu io=%u/%u",
            (unsigned long)clockHz,
            digitalRead(TOF_I2C_SDA),
            digitalRead(TOF_I2C_SCL));
        return;
    }

    const uint8_t err09 = i2cProbeAddress((uint8_t)0x09U);
    const uint8_t err0A = i2cProbeAddress((uint8_t)0x0AU);
    const uint8_t err0B = i2cProbeAddress((uint8_t)0x0BU);
    const uint8_t err0C = i2cProbeAddress((uint8_t)0x0CU);
    const uint8_t err36 = as5600Sensor.probeAddress(millis());

    makeReliableLog(
        LOG_INFO,
        "I2C scan clk=%lu 09=%s/%u 0A=%s/%u 0B=%s/%u 0C=%s/%u 36=%s/%u io=%u/%u",
        (unsigned long)clockHz,
        (err09 == 0U) ? "ack" : "miss",
        err09,
        (err0A == 0U) ? "ack" : "miss",
        err0A,
        (err0B == 0U) ? "ack" : "miss",
        err0B,
        (err0C == 0U) ? "ack" : "miss",
        err0C,
        (err36 == 0U) ? "ack" : "miss",
        err36,
        digitalRead(TOF_I2C_SDA),
        digitalRead(TOF_I2C_SCL));
}

static void logI2cBootScan()
{
    logI2cBootScanAtClock(kTofI2cSlowProbeClockHz);
#if I2C_DIAG_LOGS
    if (kTofI2cFastProbeClockHz != kTofI2cSlowProbeClockHz)
    {
        logI2cBootScanAtClock(kTofI2cFastProbeClockHz);
    }
#endif
    setTofI2cClock(tofI2cClockHz);
}

static bool ensureAs5600BusReady(uint32_t now)
{
    return serviceTofBusMonitor(now);
}

static void logAs5600FailureIfDue(uint32_t now)
{
    if (as5600LastReadFailLogMs != 0U &&
        now - as5600LastReadFailLogMs < As5600Sensor::kFailureLogIntervalMs)
    {
        return;
    }

    makeReliableLog(
        LOG_WARN,
        "AS5600 read fail st=%u n=%u total=%lu last=%u valid=%u io=%u/%u",
        as5600Sensor.lastI2cStatus(),
        as5600Sensor.consecutiveFailures(),
        (unsigned long)as5600Sensor.totalReadFailures(),
        as5600Sensor.lastGoodAngleRaw(),
        as5600Sensor.hasLastGoodAngle() ? 1U : 0U,
        digitalRead(TOF_I2C_SDA),
        digitalRead(TOF_I2C_SCL));
    as5600LastReadFailLogMs = (now == 0U) ? 1U : now;
}

static void latchAs5600Fault(const char *context, uint8_t i2cStatus)
{
    as5600Sensor.forceFault(i2cStatus);
    if ((alertMan.getErrorCode() & (uint16_t)FAULT_AS5600) == 0U)
    {
        setFault(FAULT_AS5600);
        makeReliableLog(
            LOG_ERROR,
            "AS5600 unavailable %s st=%u n=%u age=%lu io=%u/%u",
            context != nullptr ? context : "runtime",
            i2cStatus,
            as5600Sensor.consecutiveFailures(),
            (unsigned long)as5600Sensor.lastGoodSampleAgeMs(millis()),
            digitalRead(TOF_I2C_SDA),
            digitalRead(TOF_I2C_SCL));
    }
    if (motorStart != 0U)
    {
        motor_Force_Stop();
    }
}

static void serviceAs5600Safety(uint32_t now)
{
    const uint32_t failuresBefore = as5600Sensor.totalReadFailures();
    as5600Sensor.service(now);
    if (as5600Sensor.totalReadFailures() != failuresBefore)
    {
        logAs5600FailureIfDue(now);
    }
    clearRecoveredAs5600FaultIfSafe(now);
    if (as5600Sensor.shouldDeclareFault(now))
    {
        latchAs5600Fault("health_monitor", as5600Sensor.lastI2cStatus());
    }
}

static void clearRecoveredAs5600FaultIfSafe(uint32_t now)
{
    if ((alertMan.getErrorCode() & (uint16_t)FAULT_AS5600) == 0U ||
        !as5600Sensor.angleValid(now) || !isPhysicallyStationary())
    {
        return;
    }

    alertMan.clearFault(FAULT_AS5600);
    makeReliableLog(
        LOG_INFO,
        "AS5600 clear=alive ok=%u rec=%lu fail=%lu angle=%u age=%lu",
        as5600Sensor.consecutiveSuccesses(),
        (unsigned long)as5600Sensor.totalRecoveries(),
        (unsigned long)as5600Sensor.totalReadFailures(),
        as5600Sensor.lastGoodAngleRaw(),
        (unsigned long)as5600Sensor.lastGoodSampleAgeMs(now));

    if (alertMan.getErrorCode() == 0U)
    {
        clearManualRadioHold();
        pendingDisplayManualModeBypass = false;
        statusSourceRadio              = false;
        status                         = 0;
        currentOperation               = STATE_IDLE;
        digitalWrite(RED_LED, LOW);
        currentMode = CoreOpMode::IDLE;
        makeLog(LOG_INFO, "All faults cleared after stable AS5600 recovery -> idle");
    }
}

static bool readAs5600AngleForMotion(uint16_t *rawAngle)
{
    if (rawAngle == nullptr)
    {
        return false;
    }
    const uint32_t failuresBefore = as5600Sensor.totalReadFailures();
    if (as5600Sensor.readAngle(rawAngle))
    {
        return true;
    }
    if (as5600Sensor.totalReadFailures() != failuresBefore)
    {
        logAs5600FailureIfDue(millis());
    }
    latchAs5600Fault("motion_read", as5600Sensor.lastI2cStatus());
    return false;
}

static bool readAs5600AngleFresh(int *angleOut)
{
    if (angleOut == nullptr)
    {
        return false;
    }

    uint16_t rawAngle = 0;
    const uint32_t failuresBefore = as5600Sensor.totalReadFailures();
    if (!as5600Sensor.readAngle(&rawAngle))
    {
        if (as5600Sensor.totalReadFailures() != failuresBefore)
        {
            logAs5600FailureIfDue(millis());
        }
        latchAs5600Fault("calibration_read", as5600Sensor.lastI2cStatus());
        return false;
    }

    *angleOut = rawAngle;
    return true;
}

static void logBootResetReplay()
{
    makeReliableLog(
        LOG_INFO,
        "Reset replay %s flags=%08lX marker=%08lX",
        primaryResetCategoryName(lastBootResetFlags),
        (unsigned long)lastBootResetFlags,
        (unsigned long)lastBootResetMarkerFlags);
    logPreviousBreadcrumbIfWatchdog(lastBootResetFlags);
}

static void logTofI2cLines(const char *tag)
{
    makeReliableLog(
        LOG_INFO,
        "TOF I2C %s clk=%lu io=%u/%u",
        tag != nullptr ? tag : "?",
        (unsigned long)tofI2cClockHz,
        digitalRead(TOF_I2C_SDA),
        digitalRead(TOF_I2C_SCL));
}

static void stopTofI2cBus()
{
    if (!tofWireActive)
    {
        return;
    }
#if defined(TWOWIRE_HAS_END) || defined(WIRE_HAS_END)
    Wire.end();
#endif
    tofWireActive = false;
}

static void initTofI2cBus()
{
    Wire.setSDA(TOF_I2C_SDA);
    Wire.setSCL(TOF_I2C_SCL);
    Wire.begin();
    setTofI2cClock(tofI2cClockHz);
    tofWireActive = true;
}


static const char *tofBusStateName(TofBusState state)
{
    switch (state)
    {
    case TofBusState::Ready:
        return "ready";
    case TofBusState::LowPending:
        return "low_pending";
    case TofBusState::SdaStuck:
        return "sda_stuck";
    case TofBusState::SclBlocked:
        return "scl_blocked";
    case TofBusState::Recovering:
        return "recovering";
    default:
        return "unknown";
    }
}

static void setTofBusState(TofBusState next, const char *reason)
{
    if (tofBusState == next)
    {
        return;
    }

    const TofBusState previous = tofBusState;
    tofBusState                = next;
    if (next == TofBusState::LowPending || (previous == TofBusState::LowPending && next == TofBusState::Ready))
    {
        return;
    }
    const uint32_t now         = millis();
    if (tofLastBusStateLogMs == 0U || now - tofLastBusStateLogMs >= kTofFailureLogIntervalMs)
    {
        makeReliableLog(
            (next == TofBusState::Ready) ? LOG_INFO : LOG_WARN,
            "TOF bus %s>%s %s io=%u/%u",
            tofBusStateName(previous),
            tofBusStateName(next),
            reason != nullptr ? reason : "?",
            digitalRead(TOF_I2C_SDA),
            digitalRead(TOF_I2C_SCL));
        tofLastBusStateLogMs = (now == 0U) ? 1U : now;
    }
}

static bool tofRecoveryCooldownElapsed(uint32_t now)
{
    return tofI2cRecoveryCount == 0U || now - tofLastI2cRecoveryAttemptMs >= kTofI2cRecoveryMinIntervalMs;
}

static void tofDriveLineLow(uint32_t pin)
{
#if defined(OUTPUT_OPEN_DRAIN)
    pinMode(pin, OUTPUT_OPEN_DRAIN);
#else
    pinMode(pin, OUTPUT);
#endif
    digitalWrite(pin, LOW);
}

static void tofReleaseLine(uint32_t pin)
{
#if defined(OUTPUT_OPEN_DRAIN)
    pinMode(pin, OUTPUT_OPEN_DRAIN);
    digitalWrite(pin, HIGH);
#else
    pinMode(pin, INPUT_PULLUP);
#endif
}

static void logTofRecovery(
    const char *reason, uint8_t sdaBefore, uint8_t sclBefore, uint8_t sdaAfter, uint8_t sclAfter)
{
    const uint32_t now = millis();
    if (!tofI2cRecoveryLogged || now - tofLastI2cRecoveryLogMs >= 60000U)
    {
        makeReliableLog(
            LOG_WARN,
            "TOF I2C rec #%lu %s io=%u/%u>%u/%u",
            (unsigned long)tofI2cRecoveryCount,
            reason != nullptr ? reason : "?",
            sdaBefore,
            sclBefore,
            sdaAfter,
            sclAfter);
        tofI2cRecoveryLogged    = true;
        tofLastI2cRecoveryLogMs = (now == 0U) ? 1U : now;
    }
}

static bool performTofWireReinit(const char *reason)
{
    if (!tofBusLinesHighNow())
    {
        return false;
    }

    const uint32_t now       = millis();
    const uint8_t  sdaBefore = digitalRead(TOF_I2C_SDA);
    const uint8_t  sclBefore = digitalRead(TOF_I2C_SCL);
    tofLastI2cRecoveryAttemptMs = now;
    tofI2cRecoveryCount++;
    writeBreadcrumb(BC_TOF_RECOVERY, 0xFF, 0, 0);
    setWarning(WARN_I2C_RECOVERY, 3000);
    setTofBusState(TofBusState::Recovering, reason);

    stopTofI2cBus();
    initTofI2cBus();

    const uint8_t sdaAfter = digitalRead(TOF_I2C_SDA);
    const uint8_t sclAfter = digitalRead(TOF_I2C_SCL);
    logTofRecovery(reason, sdaBefore, sclBefore, sdaAfter, sclAfter);
    if (sdaAfter == HIGH && sclAfter == HIGH)
    {
        setTofBusState(TofBusState::Ready, reason);
        tofLineLowSinceMs       = 0U;
        tofLinesHighSinceMs     = 0U;
        tofSdaRecoveryAttempted = false;
        return true;
    }

    tofLineLowSinceMs = now;
    tofSdaRecoveryAttempted = true;
    setTofBusState(sclAfter == LOW ? TofBusState::SclBlocked : TofBusState::SdaStuck, reason);
    return false;
}

static bool performTofSdaClockRecovery(const char *reason)
{
    if (digitalRead(TOF_I2C_SCL) == LOW)
    {
        return false;
    }

    const uint32_t now       = millis();
    const uint8_t  sdaBefore = digitalRead(TOF_I2C_SDA);
    const uint8_t  sclBefore = digitalRead(TOF_I2C_SCL);
    tofLastI2cRecoveryAttemptMs = now;
    tofI2cRecoveryCount++;
    tofSdaRecoveryAttempted = true;
    writeBreadcrumb(BC_TOF_RECOVERY, 0xFF, 0, 1);
    setWarning(WARN_I2C_RECOVERY, 3000);
    setTofBusState(TofBusState::Recovering, reason);

    stopTofI2cBus();

    tofReleaseLine(TOF_I2C_SDA);
    tofReleaseLine(TOF_I2C_SCL);
    delayMicroseconds(10);
    for (uint8_t i = 0U; i < 16U && digitalRead(TOF_I2C_SDA) == LOW; ++i)
    {
        if (digitalRead(TOF_I2C_SCL) == LOW)
        {
            break;
        }
        tofDriveLineLow(TOF_I2C_SCL);
        delayMicroseconds(10);
        tofReleaseLine(TOF_I2C_SCL);
        delayMicroseconds(10);
    }

    tofDriveLineLow(TOF_I2C_SDA);
    delayMicroseconds(10);
    tofReleaseLine(TOF_I2C_SCL);
    delayMicroseconds(10);
    tofReleaseLine(TOF_I2C_SDA);
    delayMicroseconds(10);
    initTofI2cBus();

    const uint8_t sdaAfter = digitalRead(TOF_I2C_SDA);
    const uint8_t sclAfter = digitalRead(TOF_I2C_SCL);
    logTofRecovery(reason, sdaBefore, sclBefore, sdaAfter, sclAfter);
    if (sdaAfter == HIGH && sclAfter == HIGH)
    {
        setTofBusState(TofBusState::Ready, reason);
        tofLineLowSinceMs       = 0U;
        tofLinesHighSinceMs     = 0U;
        tofSdaRecoveryAttempted = false;
        return true;
    }

    tofLineLowSinceMs = now;
    setTofBusState(sclAfter == LOW ? TofBusState::SclBlocked : TofBusState::SdaStuck, reason);
    return false;
}

static bool performTofSclReleaseRecovery(const char *reason)
{
    const uint32_t now       = millis();
    const uint8_t  sdaBefore = digitalRead(TOF_I2C_SDA);
    const uint8_t  sclBefore = digitalRead(TOF_I2C_SCL);
    tofLastI2cRecoveryAttemptMs = now;
    tofI2cRecoveryCount++;
    writeBreadcrumb(BC_TOF_RECOVERY, 0xFF, 0, 2);
    setWarning(WARN_I2C_RECOVERY, 3000);
    setTofBusState(TofBusState::Recovering, reason);

    stopTofI2cBus();
    tofReleaseLine(TOF_I2C_SDA);
    tofReleaseLine(TOF_I2C_SCL);
    delay(2);

    const uint8_t sdaReleased = digitalRead(TOF_I2C_SDA);
    const uint8_t sclReleased = digitalRead(TOF_I2C_SCL);
    bool          recovered   = false;
    if (sdaReleased == HIGH && sclReleased == HIGH)
    {
        initTofI2cBus();
        recovered = tofBusLinesHighNow();
    }

    const uint8_t sdaAfter = digitalRead(TOF_I2C_SDA);
    const uint8_t sclAfter = digitalRead(TOF_I2C_SCL);
    if (tofLastSclReleaseLogMs == 0U || now - tofLastSclReleaseLogMs >= kTofI2cRecoveryMinIntervalMs)
    {
        makeReliableLog(
            recovered ? LOG_INFO : LOG_WARN,
            "TOF SCL release #%lu %s io=%u/%u>%u/%u",
            (unsigned long)tofI2cRecoveryCount,
            reason != nullptr ? reason : "?",
            sdaBefore,
            sclBefore,
            sdaAfter,
            sclAfter);
        tofLastSclReleaseLogMs = (now == 0U) ? 1U : now;
    }

    if (recovered)
    {
        setTofBusState(TofBusState::Ready, reason);
        tofLineLowSinceMs       = 0U;
        tofLinesHighSinceMs     = 0U;
        tofSdaRecoveryAttempted = false;
        resetTofBusVote();
        return true;
    }

    tofLineLowSinceMs       = now;
    tofLinesHighSinceMs     = 0U;
    tofSdaRecoveryAttempted = true;
    setTofBusState(sclAfter == LOW ? TofBusState::SclBlocked : TofBusState::SdaStuck, reason);
    return false;
}

static bool recoverTofBusForManualClear()
{
    const bool sdaHigh = digitalRead(TOF_I2C_SDA) == HIGH;
    const bool sclHigh = digitalRead(TOF_I2C_SCL) == HIGH;
    bool       electricalRecoveryOk;
    if (!sclHigh)
    {
        electricalRecoveryOk = performTofSclReleaseRecovery("manual_reset");
    }
    else if (!sdaHigh)
    {
        electricalRecoveryOk = performTofSdaClockRecovery("manual_reset");
    }
    else
    {
        electricalRecoveryOk = performTofWireReinit("manual_reset");
    }

    if (!electricalRecoveryOk || !tofWireActive || !tofBusLinesHighNow())
    {
        return false;
    }

    const uint8_t tofAckMask = scanTofAddressMask();
    const bool    as5600Ack  = as5600Sensor.probeAddress(millis()) == 0U;
    const bool    busVerified = tofAckMask != 0U || as5600Ack;
    makeReliableLog(
        busVerified ? LOG_INFO : LOG_WARN,
        "TOF manual verify mask=%X as=%u io=%u/%u",
        tofAckMask,
        as5600Ack ? 1U : 0U,
        digitalRead(TOF_I2C_SDA),
        digitalRead(TOF_I2C_SCL));
    return busVerified;
}

static bool serviceTofBusMonitor(uint32_t now)
{
    const bool sdaHigh = digitalRead(TOF_I2C_SDA) == HIGH;
    const bool sclHigh = digitalRead(TOF_I2C_SCL) == HIGH;

    if (sdaHigh && sclHigh)
    {
        tofLineLowSinceMs = 0U;
        if (tofBusState == TofBusState::Ready)
        {
            return true;
        }
        if (tofBusState == TofBusState::LowPending)
        {
            setTofBusState(TofBusState::Ready, "brief_low");
            return true;
        }
        if (tofBusState == TofBusState::Recovering)
        {
            return false;
        }

        if (tofLinesHighSinceMs == 0U)
        {
            tofLinesHighSinceMs = (now == 0U) ? 1U : now;
            return false;
        }
        if (now - tofLinesHighSinceMs < kTofLineReleaseConfirmMs)
        {
            return false;
        }

        return performTofWireReinit("line_release");
    }

    tofLinesHighSinceMs = 0U;
    if (tofBusState == TofBusState::Ready)
    {
        tofLineLowSinceMs = now;
        setTofBusState(TofBusState::LowPending, "line_low");
        return false;
    }

    if (tofBusState == TofBusState::SclBlocked)
    {
        if (tofRecoveryCooldownElapsed(now))
        {
            return performTofSclReleaseRecovery("scl_release");
        }
        return false;
    }

    if (tofBusState == TofBusState::LowPending)
    {
        if (now - tofLineLowSinceMs < kTofLineLowConfirmMs)
        {
            return false;
        }
        if (!sclHigh)
        {
            setTofBusState(TofBusState::SclBlocked, "scl_blocked");
            return false;
        }
        setTofBusState(TofBusState::SdaStuck, "sda_stuck");
        tofSdaRecoveryAttempted = false;
    }

    if (!sclHigh)
    {
        setTofBusState(TofBusState::SclBlocked, "scl_blocked");
        return false;
    }

    if (tofBusState == TofBusState::SdaStuck && !tofSdaRecoveryAttempted && tofRecoveryCooldownElapsed(now))
    {
        return performTofSdaClockRecovery("sda_stuck");
    }
    return false;
}

static bool readTofBootPresence(uint8_t id, TofI2cDiagnostics &diag)
{
    diag                  = {};
    diag.address          = TOF_BASE_I2C_ADDR + id;
    diag.expected         = id;
    if (!tofBusLinesHighNow())
    {
        diag.status = TOF_I2C_BUS_STUCK;
        return false;
    }

    const bool ok = TOF_Is_Device_Present(id, &diag);
    IWatchdog.reload();
    return ok;
}
static bool readTofBootPresenceIfAck(uint8_t id, uint8_t ackMask, TofI2cDiagnostics &diag)
{
    diag          = {};
    diag.address  = TOF_BASE_I2C_ADDR + id;
    diag.expected = id;

    if ((ackMask & (uint8_t)(1U << (id - 1U))) == 0U)
    {
        diag.status = TOF_I2C_NO_ACK;
        return false;
    }

    return readTofBootPresence(id, diag);
}

static void logTofBootSnapshot()
{
    if (!tofBusLinesHighNow())
    {
        makeReliableLog(
            LOG_WARN,
            "TOF boot skip clk=%lu io=%u/%u",
            (unsigned long)tofI2cClockHz,
            digitalRead(TOF_I2C_SDA),
            digitalRead(TOF_I2C_SCL));
        return;
    }

    const uint8_t tofAckMask = scanTofAddressMask();
    if (tofAckMask == 0U)
    {
        makeReliableLog(
            LOG_WARN,
            "TOF boot noack clk=%lu io=%u/%u",
            (unsigned long)tofI2cClockHz,
            digitalRead(TOF_I2C_SDA),
            digitalRead(TOF_I2C_SCL));
        return;
    }

    TofI2cDiagnostics channelForward = {};
    TofI2cDiagnostics channelReverse = {};
    TofI2cDiagnostics palletForward  = {};
    TofI2cDiagnostics palletReverse  = {};

    const bool channelForwardOk = readTofBootPresenceIfAck(2, tofAckMask, channelForward);
    const bool channelReverseOk = readTofBootPresenceIfAck(1, tofAckMask, channelReverse);
    const bool palletForwardOk  = readTofBootPresenceIfAck(4, tofAckMask, palletForward);
    const bool palletReverseOk  = readTofBootPresenceIfAck(3, tofAckMask, palletReverse);

    makeReliableLog(
        LOG_INFO,
        "TOF boot m=%02X cf=%u/%s/%u cr=%u/%s/%u pf=%u/%s/%u pr=%u/%s/%u io=%u/%u",
        tofAckMask,
        channelForwardOk,
        TOF_I2C_Status_Name(channelForward.status),
        channelForward.received,
        channelReverseOk,
        TOF_I2C_Status_Name(channelReverse.status),
        channelReverse.received,
        palletForwardOk,
        TOF_I2C_Status_Name(palletForward.status),
        palletForward.received,
        palletReverseOk,
        TOF_I2C_Status_Name(palletReverse.status),
        palletReverse.received,
        digitalRead(TOF_I2C_SDA),
        digitalRead(TOF_I2C_SCL));
}

static void logI2cDiagSummaryIfDue(uint32_t now)
{
#if I2C_DIAG_LOGS
    static uint32_t lastLogMs = 0;
    const uint16_t tofFaultMask = (uint16_t)FAULT_TOF_CH_F | (uint16_t)FAULT_TOF_CH_R |
                                  (uint16_t)FAULT_TOF_PAL_F | (uint16_t)FAULT_TOF_PAL_R;
    const bool hasI2cEvidence = ((alertMan.getWarningCode() & (uint16_t)WARN_I2C_RECOVERY) != 0U) ||
                                ((alertMan.getErrorCode() & tofFaultMask) != 0U) ||
                                as5600Sensor.totalReadFailures() != 0U ||
                                tofI2cRecoveryCount != 0U;
    if (!hasI2cEvidence)
    {
        return;
    }
    if (lastLogMs != 0U && now - lastLogMs < kI2cDiagSummaryIntervalMs)
    {
        return;
    }
    lastLogMs = (now == 0U) ? 1U : now;

    makeReliableLog(
        LOG_INFO,
        "I2C diag clk=%lu e=%04X w=%04X tof=%u/%u/%u/%u st=%s/%s/%s/%s b=%u/%u/%u/%u rec=%lu asf=%lu io=%u/%u",
        (unsigned long)tofI2cClockHz,
        alertMan.getErrorCode(),
        alertMan.getWarningCode(),
        tofSensorErrors[0],
        tofSensorErrors[1],
        tofSensorErrors[2],
        tofSensorErrors[3],
        TOF_I2C_Status_Name((TofI2cStatus)tofLastDiagStatus[0]),
        TOF_I2C_Status_Name((TofI2cStatus)tofLastDiagStatus[1]),
        TOF_I2C_Status_Name((TofI2cStatus)tofLastDiagStatus[2]),
        TOF_I2C_Status_Name((TofI2cStatus)tofLastDiagStatus[3]),
        tofSharedBusErrors[0],
        tofSharedBusErrors[1],
        tofSharedBusErrors[2],
        tofSharedBusErrors[3],
        (unsigned long)tofI2cRecoveryCount,
        (unsigned long)as5600Sensor.totalReadFailures(),
        digitalRead(TOF_I2C_SDA),
        digitalRead(TOF_I2C_SCL));
#else
    (void)now;
#endif
}

static BmsDdA5Firmware::Adapter batteryBms(SerialRS485, RS485, makeLogImpl, makeBatteryPollConfig());
static BatterySafetyState       batterySafetyState;

int      lifterCurrent        = 0;    // Ток лифтера для оценки массы поднимаемого груза
int      angle                = 0;    // Значение угла полученное от магнитного экодера
int      oldAngle             = 0;    // Промежуточное значение угла для расчетов
int      startAngle           = 0;    // Промежуточное значение угла для расчетов
int      turnCount            = 0;    // Счетчик оборотов колеса
int      channelLength        = 0;    // Расчетная длинна канала
int      currentPosition      = 0;    // Текущая позиция шаттла
int      oldPosition          = 0;    // Позиция для определения останова шаттла
int      lastPalletePosition  = 0;    // Позиция последнего паллета после загрузки
int      firstPalletePosition = 0;    // Позиция первого паллета при уплотнении вперед
int      lifter_Speed         = 3700; // Скорость двигателя лифтера -сохранять-
int      lifterDelay          = 3800; // Задержка лифтера
int      oldChannelDistanse   = 0;    // Канальная дистанция для фильтрации фантомных срабатываний
int      oldPalleteDistanse   = 0;    // Паллетная дистанция для фильтрации фантомных срабатываний
uint32_t timingBudget         = 40;   // Время измерения датчиками

float temp    = 0;   // Температура чипа
float weelDia = 100; // Диаметр колеса

uint16_t mesRes[2][4];
int      countCrush = 0;
int      startDiff  = 0;

uint8_t  sensorIndex = 0;

#pragma endregion

// Инициация устройств
void setup()
{
    if (consumeBootloaderResetRequest())
    {
        jumpToBootloader();
    }

    pinMode(GREEN_LED, OUTPUT);
    pinMode(BOARD_LED, OUTPUT);
    pinMode(RED_LED, OUTPUT);
    pinMode(WHITE_LED, OUTPUT);
    pinMode(ZOOMER, OUTPUT);
    pinMode(RADIO_E22_M0, OUTPUT);
    pinMode(RADIO_E22_M1, OUTPUT);
    pinMode(RADIO_E22_AUX, INPUT_PULLUP);
    pinMode(RS485, OUTPUT);
    pinMode(DATCHIK_F1, INPUT_PULLUP);
    pinMode(DATCHIK_R1, INPUT_PULLUP);
    pinMode(DATCHIK_F2, INPUT_PULLUP);
    pinMode(DATCHIK_R2, INPUT_PULLUP);
    pinMode(DL_UP, INPUT_PULLUP);
    pinMode(DL_DOWN, INPUT_PULLUP);
    pinMode(BUMPER_F1, INPUT);
    pinMode(BUMPER_F2, INPUT);
    pinMode(BUMPER_R1, INPUT);
    pinMode(BUMPER_R2, INPUT);
    pinMode(CHANNEL, INPUT);

    attachInterrupt(BUMPER_F1, crashF1Irq, FALLING);
    attachInterrupt(BUMPER_F2, crashF2Irq, FALLING);
    attachInterrupt(BUMPER_R1, crashR1Irq, FALLING);
    attachInterrupt(BUMPER_R2, crashR2Irq, FALLING);

    digitalWrite(GREEN_LED, HIGH);
    digitalWrite(BOARD_LED, HIGH);
    digitalWrite(RED_LED, LOW);
    digitalWrite(WHITE_LED, LOW);
    digitalWrite(ZOOMER, LOW);
    digitalWrite(RS485, LOW);
    digitalWrite(RADIO_E22_M0, LOW);
    digitalWrite(RADIO_E22_M1, LOW);

    SerialDisplay.begin(230400, SERIAL_8E1);
    SerialRS485.begin(9600);
    SerialLora.begin(E22Radio::uartBaudValue(kRadioHostBaud));
    serialLinksStarted = true;

    uint32_t displayWaitStart = millis();
    while (!SerialDisplay && (millis() - displayWaitStart < 1500))
    {
        delay(10);
    }

    delay(kBootLogSettleMs);

    initStatsSRAM();
    recordBootResetCause();
    writeBreadcrumb(BC_BOOT, 0xFF, 0, 0);
    __HAL_RCC_CLEAR_RESET_FLAGS();

    read_EEPROM_Data();
    applyRadioConfigAtBoot();
    analogReadResolution(12);

    makeBootLog(LOG_INFO, "Start init board...");
    makeBootLog(
        LOG_INFO,
        "FW Cntrl_V2 v%u.%u.%u",
        kFirmwareVersionMajor,
        kFirmwareVersionMinor,
        kFirmwareVersionPatch);

    Can1.begin();
    Can1.setBaudRate(500000);
    CAN_TX_msg.flags.extended = 1;
    CAN_RX_msg.flags.extended = 1;

    initTofI2cBus();
    logTofI2cLines("after init");

    const bool encoderOk = as5600Sensor.begin(millis());
    if (!encoderOk)
    {
        logAs5600FailureIfDue(millis());
    }
    if (encoderOk)
        makeBootLog(LOG_INFO, "Init encoder success...");
    else
        makeBootLog(LOG_ERROR, "Init encoder failed...");

    logTofI2cLines("after encoder");
    logI2cBootScan();
    logTofBootSnapshot();

    makeLog(LOG_DEBUG, "Total struct size = %d", sizeof(EEPROMData));
    delay(10);

    makeLog(LOG_INFO, "Initialize RTC date and time.");
    delay(50);

    rtc.setClockSource(STM32RTC::LSE_CLOCK);
    rtc.begin();

    if (!rtc.isTimeSet()) // Инициируем часы RTC
    {
        rtc.setTime(0, 0, 0);
        rtc.setDate(1, 1, 1, 23);
        makeLog(LOG_INFO, "RTC initialized with default date and time.");
    }

    makeLog(LOG_INFO, "Complete initialize RTC date and time.");

    delay(50);
    // char report[256];
    temp = 25 + ((float)(analogRead(ATEMP) * 3200) / 4096 - 760) / 2.5;
    uint8_t hour, minute, second, day, month, year, weekDay;
    rtc.getTime(&hour, &minute, &second, 0, nullptr);
    rtc.getDate(&weekDay, &day, &month, &year);
    makeBootLog(LOG_INFO, "Boot: %02d:%02d:%02d %02d/%02d/%02d T=%.1f", hour, minute, second, day, month, year, temp);
    makeBootLog(
        LOG_INFO,
        "Boot complete FW v%u.%u.%u reset=%s flags=%08lX marker=%08lX",
        kFirmwareVersionMajor,
        kFirmwareVersionMinor,
        kFirmwareVersionPatch,
        primaryResetCategoryName(lastBootResetFlags),
        (unsigned long)lastBootResetFlags,
        (unsigned long)lastBootResetMarkerFlags);
    delay(500);
    IWatchdog.begin(10000000);
    logBootResetReplay();
    batteryBms.begin(millis());
    batteryCharge = batteryBms.socPercent();
    const uint32_t tofStartMs = millis();
    tofRuntimeStarted         = true;
    for (uint8_t i = 0U; i < 4U; ++i)
    {
        tofHealth[i].reset(tofStartMs);
    }
}

// Основной цикл
void loop()
{
    writeBreadcrumb(BC_LOOP, 0xFF, 0, 0);
    SystemYield();
    handlePendingCrash();

    if (pendingEepromSave && motorStart == 0 && motorReverse == 2)
    {
        saveConfigsToFlash();
        pendingEepromSave = false;
    }

    get_Distance();

    if (isErrorActive())
        currentMode = CoreOpMode::ERROR;

    switch (currentMode)
    {
    case CoreOpMode::IDLE:
    {
        if (status != 0 && status != CMD_STOP)
        {

            uint8_t inChannel = digitalRead(CHANNEL);
            delay(5);
            inChannel = digitalRead(CHANNEL) && inChannel;
            delay(5);
            inChannel = digitalRead(CHANNEL) && inChannel;

            if (!inChannel && !isOutOfChannelExemptCommand(status))
            {
                makeLog(LOG_WARN, "Command 0x%02X rejected: Shuttle not in channel", status);
                setWarning(WARN_NOT_IN_CHANNEL, 5000);
                status = 0;
            }
            else
            {
                currentOperation = mapCmdToOperation(status);
                makeLog(LOG_INFO, "Shuttle accepted CMD: 0x%02X -> State %d", status, currentOperation);
                lastPalletePosition = 0;
                send_Cmd();

                if (status == CMD_MANUAL_MODE || pendingDisplayManualModeBypass)
                {
                    const bool bypassedFromDisplay = pendingDisplayManualModeBypass;
                    clearManualRadioHold();
                    touchManualSession();
                    currentOperation = STATE_MANUAL;
                    if (bypassedFromDisplay)
                    {
                        makeLog(LOG_INFO, "Manual mode bypass from display command: 0x%02X", status);
                    }
                    makeLog(
                        LOG_INFO,
                        "Manual enter cmd=%02X src=%s",
                        status,
                        bypassedFromDisplay ? "display" : (statusSourceRadio ? "radio" : "display"));
                    pendingDisplayManualModeBypass = false;
                    currentMode                    = CoreOpMode::MANUAL;
                    send_Cmd();
                }
                else
                {
                    clearManualRadioHold();
                    currentMode = CoreOpMode::AUTO_EXEC;
                }
            }
        }

        if (digitalRead(WHITE_LED))
            digitalWrite(WHITE_LED, LOW);
        Can1.read(CAN_RX_msg);

        if (millis() - count > 1000 && !motorStart)
        {
            counter = 0;
            digitalToggle(GREEN_LED);
            digitalToggle(BOARD_LED);
            reportCounter++;
            count = millis();
            SystemYield();
            if (reportCounter == 10)
            {
                reportCounter = 0;
            }
            send_Cmd();
        }

        detect_Pallete();
        break;
    }

    case CoreOpMode::AUTO_EXEC:
    {
        run_Cmd();

        if (status != CMD_STOP)
        {
            status = 0;
        }
        currentOperation = STATE_IDLE;
        currentMode      = CoreOpMode::IDLE;
        break;
    }

    case CoreOpMode::MANUAL:
    {
        if (status == CMD_MOVE_RIGHT_MAN)
        {
            moove_Right();
        }
        else if (status == CMD_MOVE_LEFT_MAN)
        {
            moove_Left();
        }
        else if (status == CMD_MOVE_DIST_R || status == CMD_MOVE_DIST_F)
        {
            clearManualRadioHold();
            currentOperation = STATE_MANUAL;
            makeLog(
                LOG_INFO,
                "Manual step start dir=%s dist=%ld",
                status == CMD_MOVE_DIST_F ? "forward" : "reverse",
                (long)mooveDistance);
            send_Cmd();
            touchManualSession();
            if (status == CMD_MOVE_DIST_F)
            {
                moove_Distance_F(mooveDistance);
            }
            else
            {
                moove_Distance_R(mooveDistance);
            }
            if (!shouldAbortLoop())
            {
                touchManualSession();
                status           = CMD_MANUAL_MODE;
                currentOperation = STATE_MANUAL;
                makeLog(LOG_INFO, "Manual step done -> ready");
                send_Cmd();
            }
            else
            {
                makeLog(LOG_WARN, "Manual step abort status=%02X", status);
            }
        }
        else if (status == CMD_STOP_MANUAL)
        {
            clearManualRadioHold();
            touchManualSession();
            pendingDisplayManualModeBypass = false;
            status                         = CMD_MANUAL_MODE;
            currentOperation               = STATE_MANUAL;
            makeLog(LOG_INFO, "Manual stop -> ready");
            send_Cmd();
        }
        else if (status == CMD_LIFT_UP || status == CMD_LIFT_DOWN)
        {
            clearManualRadioHold();
            currentOperation = STATE_MANUAL;
            makeLog(LOG_INFO, "Manual lift start dir=%s", status == CMD_LIFT_UP ? "up" : "down");
            send_Cmd();
            touchManualSession();
            if (status == CMD_LIFT_UP)
            {
                lifter_Up();
            }
            else
            {
                lifter_Down();
            }
            if (!shouldAbortLoop())
            {
                touchManualSession();
                status           = CMD_MANUAL_MODE;
                currentOperation = STATE_MANUAL;
                makeLog(LOG_INFO, "Manual lift done -> ready");
                send_Cmd();
            }
            else
            {
                makeLog(LOG_WARN, "Manual lift abort status=%02X", status);
            }
        }
        else if (status == CMD_LOAD)
        {
            currentOperation = STATE_LOAD;
            run_Cmd();
        }
        else if (status == CMD_UNLOAD)
        {
            currentOperation = STATE_UNLOAD;
            run_Cmd();
        }
        else if (status == CMD_LONG_LOAD)
        {
            currentOperation = STATE_LONG_LOAD;
            run_Cmd();
        }
        else if (status == CMD_LONG_UNLOAD)
        {
            currentOperation = STATE_LONG_UNLOAD;
            run_Cmd();
        }

        if (millis() - lastManualSessionActivityTime > kManualSessionIdleTimeoutMs)
        {
            clearManualRadioHold();
            pendingDisplayManualModeBypass = false;
            makeLog(LOG_WARN, "Manual session timeout -> idle");
            setWarning(WARN_MANUAL_TIMEOUT, 5000);
            currentOperation = STATE_IDLE;
            currentMode      = CoreOpMode::IDLE;
            status           = CMD_STOP;
        }

        if (millis() - count > 330)
        {
            digitalWrite(GREEN_LED, !digitalRead(GREEN_LED));
            digitalWrite(BOARD_LED, !digitalRead(BOARD_LED));
            count = millis();
            SystemYield();
            while (Can1.read(CAN_RX_msg))
                ;
            reportCounter++;
            if (reportCounter == 3)
            {
                delay(5);
                makeLog(LOG_DEBUG, "manual mode...");
                reportCounter = 0;
            }
        }

        if (status == CMD_STOP)
        {
            clearManualRadioHold();
            pendingDisplayManualModeBypass = false;
            makeLog(LOG_INFO, "Manual exit -> idle");
            currentOperation = STATE_IDLE;
            currentMode      = CoreOpMode::IDLE;
        }
        break;
    }
    case CoreOpMode::ERROR:
    {
        currentOperation = STATE_ERROR;
        clearManualRadioHold();
        if (!isPhysicallyStationary())
        {
            motor_Force_Stop();
        }
        if (digitalRead(WHITE_LED))
            digitalWrite(WHITE_LED, LOW);
        blink_Error();

        if (status == CMD_SYSTEM_RESET)
        {
            performSystemReset();
        }
        else if (status == CMD_RESET_ERROR)
        {
            clearLatchedAlertsAndReturnToIdle(millis());
        }
        else if (status == CMD_SAVE_EEPROM)
        {
            saveEEPROMData(eepromData);
            status = 0;
        }

        detect_Pallete();
        break;
    }
    }
}

// Функции
#pragma region Функции...

#pragma region Функции управления двигателем движения...

// Установка скорости движения
void motor_Speed(int spd)
{
    if (motorReverse == 2 || millis() - countMoove < 50)
        return;
    countMoove = millis();
    while (Can1.read(CAN_RX_msg))
        ;
    cracked_int_t hexSpeed;
    CAN_TX_msg.id  = (100);
    CAN_TX_msg.len = 4;
    uint8_t accel  = 18;
    if (spd >= 10 && spd - oldSpeed >= 10)
        spd = oldSpeed + 10;
    if (spd > 100)
        spd = 100;
    if (spd <= 100 && spd >= 0)
    {
        if (spd > oldSpeed)
        {
            uint8_t steps = (spd - oldSpeed) / 2;
            for (uint8_t i = 0; i < steps; i++)
            {
                blink_Work();
                get_Distance();
                hexSpeed.vint = minSpeed + oldSpeed * maxSpeed / 100 + (spd - oldSpeed) * i * maxSpeed / (steps * 100);
                if (motorReverse ^ inverse)
                    hexSpeed.vint = -hexSpeed.vint;
                hexSpeed.vint *= 1000;
                for (uint8_t j = 0; j < 4; j++)
                {
                    CAN_TX_msg.buf[j] = (unsigned char)hexSpeed.bint[3 - j];
                }
                Can1.write(CAN_TX_msg);
                set_Position();
                count = millis();
                if (i > 2 && i <= 40 && lifterUp)
                    accel = 80 - i * 15 / 10;
                else
                    accel = 35;
                while (millis() - count < accel)
                {
                    SystemYield();
                    blink_Work();
                    get_Distance();
                    if (shouldAbortLoop())
                    {
                        preserveManualStopOnAbort();
                        motor_Stop();
                        return;
                    }
                }
            }
            if (spd)
                hexSpeed.vint = minSpeed + spd * maxSpeed / 100;
            else
                hexSpeed.vint = 0;
            if (motorReverse ^ inverse)
                hexSpeed.vint = -hexSpeed.vint;
            hexSpeed.vint *= 1000;
            for (uint8_t i = 0; i < 4; i++)
            {
                CAN_TX_msg.buf[i] = (unsigned char)hexSpeed.bint[3 - i];
            }
            Can1.write(CAN_TX_msg);
            while (Can1.read(CAN_RX_msg))
                ;
            oldSpeed = spd;
        }
        else if (spd < oldSpeed)
        {
            uint8_t steps = (oldSpeed - spd) / 2;
            if (distance[0] <= 400 || distance[1] <= 400)
                steps /= 2;
            for (uint8_t i = 0; i < steps; i++)
            {
                blink_Work();
                get_Distance();
                hexSpeed.vint = minSpeed + oldSpeed * maxSpeed / 100 - (oldSpeed - spd) * i * maxSpeed / (steps * 100);
                if (motorReverse ^ inverse)
                    hexSpeed.vint = -hexSpeed.vint;
                hexSpeed.vint *= 1000;
                for (uint8_t j = 0; j < 4; j++)
                {
                    CAN_TX_msg.buf[j] = (unsigned char)hexSpeed.bint[3 - j];
                }
                Can1.write(CAN_TX_msg);
                set_Position();
                count = millis();
                if (lifterUp)
                    accel = 10 + i * 20 / steps;
                while (millis() - count < accel)
                {
                    SystemYield();
                    get_Distance();
                    if (shouldAbortLoop())
                    {
                        preserveManualStopOnAbort();
                        motor_Stop();
                        return;
                    }
                    if (motorReverse == 2)
                        return;
                }
            }
            if (spd)
                hexSpeed.vint = minSpeed + spd * maxSpeed / 100;
            else
                hexSpeed.vint = 0;
            if (motorReverse ^ inverse)
                hexSpeed.vint = -hexSpeed.vint;
            hexSpeed.vint *= 1000;
            for (uint8_t i = 0; i < 4; i++)
            {
                CAN_TX_msg.buf[i] = (unsigned char)hexSpeed.bint[3 - i];
            }
            Can1.write(CAN_TX_msg);
            while (Can1.read(CAN_RX_msg))
                ;
            oldSpeed = spd;
        }
        else if (spd == oldSpeed)
        {
            hexSpeed.vint = minSpeed + spd * maxSpeed / 100;
            if (motorReverse ^ inverse)
                hexSpeed.vint = -hexSpeed.vint;
            hexSpeed.vint *= 1000;
            for (uint8_t i = 0; i < 4; i++)
            {
                CAN_TX_msg.buf[i] = (unsigned char)hexSpeed.bint[3 - i];
            }
            Can1.write(CAN_TX_msg);
            while (Can1.read(CAN_RX_msg))
                ;
        }
    }
    else
    {
        hexSpeed.vint = 0;
        for (uint8_t i = 0; i < 4; i++)
        {
            CAN_TX_msg.buf[i] = (unsigned char)hexSpeed.bint[3 - i];
        }
        Can1.write(CAN_TX_msg);
        while (Can1.read(CAN_RX_msg))
            ;
        oldSpeed = 0;
    }
    set_Position();
}

// Установка движения вперед
void motor_Start_Forward()
{
    if (!ensureChannelTofReadyForMotion(true, "start_f"))
    {
        return;
    }
    motorStart   = 1;
    motorReverse = 0;
}

// Установка движения назад
void motor_Start_Reverse()
{
    if (!ensureChannelTofReadyForMotion(false, "start_r"))
    {
        return;
    }
    motorStart   = 1;
    motorReverse = 1;
}

// Остановка движения
void motor_Stop()
{
    if (motorReverse == 2)
        return;
    Can1.read(CAN_RX_msg);
    makeLog(LOG_INFO, "Motor stop, speed = %d", oldSpeed);
    CAN_TX_msg.id  = (100);
    CAN_TX_msg.len = 4;
    cracked_int_t hexSpeed;
    if (oldSpeed > 1)
    {
        uint8_t maxi = (uint8_t)oldSpeed / 2;
        for (uint8_t i = maxi; i > 0; i--)
        {
            blink_Work();
            get_Distance();
            hexSpeed.vint = minSpeed + oldSpeed * maxSpeed * i / (maxi * 100);
            hexSpeed.vint *= 1000;
            if (motorReverse ^ inverse)
                hexSpeed.vint = -hexSpeed.vint;
            for (uint8_t j = 0; j < 4; j++)
            {
                CAN_TX_msg.buf[j] = (unsigned char)hexSpeed.bint[3 - j];
            }
            Can1.write(CAN_TX_msg);
            while (Can1.read(CAN_RX_msg))
                ;
            if ((status == CMD_LONG_UNLOAD || status == CMD_UNLOAD) && lifterUp && distance[3] + 100 < distance[1])
                delay(10);
            else if (maxi > 10)
                delay(10 + i * 20 / maxi);
            else
                delay(50);
        }
    }
    set_Position();
    hexSpeed.vint = 0;
    for (uint8_t i = 0; i < 4; i++)
    {
        CAN_TX_msg.buf[i] = (unsigned char)hexSpeed.bint[3 - i];
    }
    Can1.write(CAN_TX_msg);
    while (Can1.read(CAN_RX_msg))
        ;
    if ((status == CMD_LONG_UNLOAD || status == CMD_UNLOAD) && lifterUp && distance[3] + 100 < distance[1])
    {
        for (uint8_t i = 0; i < 10; i++)
        {
            count = millis();
            while (millis() - count < 100)
                blink_Work();
            Can1.write(CAN_TX_msg);
            while (Can1.read(CAN_RX_msg))
                ;
        }
    }
    else
    {
        for (uint8_t i = 0; i < 1; i++)
        {
            count = millis();
            while (millis() - count < 100)
                blink_Work();
            Can1.write(CAN_TX_msg);
            while (Can1.read(CAN_RX_msg))
                ;
        }
    }
    oldSpeed     = 0;
    motorStart   = 0;
    motorReverse = 2;
    mooveCount   = 0;
    oldPosition  = currentPosition;
}

// Форсмажорная остановка движения
void motor_Force_Stop()
{
    cracked_int_t hexSpeed;
    oldSpeed       = 0;
    hexSpeed.vint  = 0;
    CAN_TX_msg.id  = (100);
    CAN_TX_msg.len = 4;
    for (uint8_t i = 0; i < 4; i++)
    {
        CAN_TX_msg.buf[i] = (unsigned char)hexSpeed.bint[3 - i];
    }
    Can1.write(CAN_TX_msg);
    while (Can1.read(CAN_RX_msg))
        ;
    motorStart   = 0;
    motorReverse = 2;
    mooveCount   = 0;
    oldPosition  = currentPosition;
}
#pragma endregion

#pragma region Функции управления лифтером

// Подъем платформы
void lifter_Up()
{
    if (!digitalRead(DL_UP) && digitalRead(DL_DOWN))
    {
        makeLog(LOG_DEBUG, "Lifter is up... status = %d", status);
        return;
    }
    makeLog(LOG_INFO, "Moove lifter up...");
    int           k           = 0;
    int           summCurrent = 0;
    int           current     = 0;
    cracked_int_t hexSpeed;
    uint32_t      cnt = millis();
    CAN_TX_msg.id     = (101);
    CAN_TX_msg.len    = 4;
    for (uint8_t j = 5; j < 50; j += 5)
    {
        hexSpeed.vint = -j;
        hexSpeed.vint *= 1000;
        for (uint8_t i = 0; i < 4; i++)
        {
            CAN_TX_msg.buf[i] = (unsigned char)hexSpeed.bint[3 - i];
        }
        Can1.write(CAN_TX_msg);
        while (millis() - cnt < 30)
        {
            SystemYield();
            if (shouldAbortLoop())
            {
                preserveManualStopOnAbort();
                return;
            }
        }
        cnt = millis();
    }
    cnt           = millis();
    hexSpeed.vint = -50000;
    for (uint8_t i = 0; i < 4; i++)
    {
        CAN_TX_msg.buf[i] = (unsigned char)hexSpeed.bint[3 - i];
    }
    if (digitalRead(DL_UP))
        Can1.write(CAN_TX_msg);
    while (digitalRead(DL_UP))
    {
        SystemYield();
        if (shouldAbortLoop())
        {
            preserveManualStopOnAbort();
            return;
        }
        if (millis() - cnt > (uint32_t)lifterDelay)
        {
            lifter_Stop();
            setFault(FAULT_LIFTER_TIMEOUT);
            makeLog(LOG_ERROR, "Lifter timeout!");
            status = CMD_STOP;
            break;
        }
        delay(10);
        Can1.write(CAN_TX_msg);
        blink_Work();
        get_Distance();

        while (Can1.read(CAN_RX_msg))
        {
            if (!CAN_RX_msg.flags.remote && CAN_RX_msg.id == 2405)
            {
                current = CAN_RX_msg.buf[4] * 256 + CAN_RX_msg.buf[5];
                if (lifterCurrent < current && k > 3)
                    lifterCurrent = current;
                k++;
                if (k > 3)
                    summCurrent += current;
            }
        }
    }
    Can1.write(CAN_TX_msg);
    if (digitalRead(DL_DOWN))
        lifterUp = 1;
    lifter_Stop();
    summCurrent /= k;
    if (lifterCurrent > 500)
    {
        STATS_ATOMIC_UPDATE(sramStats->payload.lifterOverloadCount++);
        lifterCurrent = 250;
    }
    makeLog(LOG_DEBUG, "Summ = %d", summCurrent);
    STATS_ATOMIC_UPDATE(sramStats->payload.liftUpCounter++);
}

// Опускание платформы
void lifter_Down()
{
    if (!digitalRead(DL_DOWN) && digitalRead(DL_UP))
    {
        makeLog(LOG_DEBUG, "Lifter is down... status = %d", status);
        return;
    }
    makeLog(LOG_INFO, "Moove lifter down... status = %d", status);
    uint32_t      cnt = millis();
    cracked_int_t hexSpeed;
    CAN_TX_msg.id  = (101);
    CAN_TX_msg.len = 4;
    for (uint8_t j = 5; j < 50; j += 5)
    {
        hexSpeed.vint = j;
        hexSpeed.vint *= 1000;
        for (uint8_t i = 0; i < 4; i++)
        {
            CAN_TX_msg.buf[i] = (unsigned char)hexSpeed.bint[3 - i];
        }
        Can1.write(CAN_TX_msg);
        while (millis() - cnt < 30)
        {
            SystemYield();
            if (shouldAbortLoop())
            {
                preserveManualStopOnAbort();
                return;
            }
        }
        cnt = millis();
    }
    cnt           = millis();
    hexSpeed.vint = 50000;
    for (uint8_t i = 0; i < 4; i++)
    {
        CAN_TX_msg.buf[i] = (unsigned char)hexSpeed.bint[3 - i];
    }
    if (digitalRead(DL_DOWN))
        Can1.write(CAN_TX_msg);
    while (digitalRead(DL_DOWN))
    {
        SystemYield();
        if (shouldAbortLoop())
        {
            preserveManualStopOnAbort();
            return;
        }
        if (millis() - cnt > (uint32_t)lifterDelay)
        {
            lifter_Stop();
            setFault(FAULT_LIFTER_TIMEOUT);
            makeLog(LOG_ERROR, "Lifter timeout!");
            status = CMD_STOP;
            break;
        }
        delay(10);
        Can1.write(CAN_TX_msg);
        blink_Work();
        get_Distance();
    }

    if (!digitalRead(DL_DOWN))
        lifterUp = 0;
    lifter_Stop();
    load          = 0;
    lifterCurrent = 0;
    STATS_ATOMIC_UPDATE(sramStats->payload.liftDownCounter++);
}

// Остановка платформы
void lifter_Stop()
{
    makeLog(LOG_INFO, "Stop lifter...");
    cracked_int_t hexSpeed;
    hexSpeed.vint  = 0;
    CAN_TX_msg.id  = (101);
    CAN_TX_msg.len = 4;
    for (uint8_t i = 0; i < 4; i++)
    {
        CAN_TX_msg.buf[i] = (unsigned char)hexSpeed.bint[3 - i];
    }
    Can1.write(CAN_TX_msg);
}
#pragma endregion

#pragma region Служебные функции

enum ParseState
{
    STATE_WAIT_SYNC1,
    STATE_WAIT_SYNC2,
    STATE_READ_HEADER,
    STATE_READ_PAYLOAD,
    STATE_READ_CRC
};

static inline bool buildRemoteRouteForShuttleId(uint8_t shuttleId, E22Radio::FixedRoute *outRoute)
{
    if (!outRoute || !E22Radio::isValidNodeId(shuttleId))
    {
        return false;
    }

    *outRoute = E22Radio::fixedRouteToRemote(shuttleId, E22Radio::kDefaultChannel440);
    return true;
}

static inline int transportAvailableForWrite(Stream *port)
{
    if (!port)
    {
        return 0;
    }

    const int available = port->availableForWrite();
    if (port != &SerialLora)
    {
        return available;
    }

    return (available > 3) ? (available - 3) : 0;
}

static size_t
writeTransportPayload(
    Stream *port,
    const uint8_t *buffer,
    uint16_t length,
    const E22Radio::FixedRoute *fixedRoute,
    RadioTxAuxPolicy auxPolicy)
{
    if (!port || !buffer || length == 0)
    {
        return 0;
    }
    if (transportAvailableForWrite(port) < length)
    {
        return 0;
    }

    if (port != &SerialLora)
    {
        return port->write(buffer, length);
    }

    if (e22Radio.hasAuxPin() && !e22Radio.waitAuxHigh(kRadioRuntimeAuxWaitMs))
    {
        LOG_RATE_LIMITED(
            LOG_WARN,
            1000,
            "Radio TX AUX busy len=%u policy=%u",
            length,
            auxPolicy == RadioTxAuxPolicy::SendAfterTimeout ? 1 : 0);
        if (auxPolicy == RadioTxAuxPolicy::DropIfBusy)
        {
            return 0;
        }
    }

    E22Radio::FixedRoute        route      = { 0, 0, 0 };
    const E22Radio::FixedRoute *routeToUse = fixedRoute;
    if (routeToUse == NULL)
    {
        if (!buildRemoteRouteForShuttleId(shuttleNum, &route))
        {
            return 0;
        }
        routeToUse = &route;
    }

    const uint8_t routeHeader[3] = { routeToUse->addh, routeToUse->addl, routeToUse->channel };
    const size_t  routeWritten   = port->write(routeHeader, sizeof(routeHeader));
    const size_t  payloadWritten = port->write(buffer, length);
    if (routeWritten != sizeof(routeHeader) || payloadWritten != length)
    {
        return 0;
    }
    return length;
}

void sendAck(uint8_t seq, AckResult result, Stream *port, const E22Radio::FixedRoute *fixedRoute)
{
    if (!port)
        return;
    uint8_t   localTxBuffer[sizeof(FrameHeader) + sizeof(AckPacket) + 2];
    AckPacket pkt;
    pkt.refSeq = seq;
    pkt.result = result;

    FrameHeader *header       = (FrameHeader *)localTxBuffer;
    header->sync1             = PROTOCOL_SYNC_1_V2;
    header->sync2             = PROTOCOL_SYNC_2_V2;
    header->length            = sizeof(AckPacket);
    header->targetID          = TARGET_ID_NONE;
    static uint8_t seqCounter = 0;
    header->seq               = seqCounter++;
    header->msgID             = MSG_ACK;

    memcpy(localTxBuffer + sizeof(FrameHeader), &pkt, sizeof(AckPacket));
    uint16_t totalLen = sizeof(FrameHeader) + header->length;
    ProtocolUtils::appendCRC(localTxBuffer, totalLen);

    if (writeTransportPayload(port, localTxBuffer, totalLen + 2, fixedRoute, RadioTxAuxPolicy::SendAfterTimeout) == totalLen + 2)
    {
        countTxFrame(port);
    }
}

void sendTelemAck(
    uint8_t                     seq,
    AckResult                   result,
    Stream                     *port,
    int16_t                     shuttleStatusOverride,
    const E22Radio::FixedRoute *fixedRoute)
{
    if (!port || pendingBootloaderEntry)
        return;

    uint8_t        localTxBuffer[sizeof(FrameHeader) + sizeof(AckTelemPacket) + 2];
    AckTelemPacket pkt;
    pkt.ack.refSeq = seq;
    pkt.ack.result = result;
    populateTelemetryPacket(&pkt.telemetry, shuttleStatusOverride);

    FrameHeader *header       = (FrameHeader *)localTxBuffer;
    header->sync1             = PROTOCOL_SYNC_1_V2;
    header->sync2             = PROTOCOL_SYNC_2_V2;
    header->length            = sizeof(AckTelemPacket);
    header->targetID          = TARGET_ID_NONE;
    static uint8_t seqCounter = 0;
    header->seq               = seqCounter++;
    header->msgID             = MSG_ACK_TELEM;

    memcpy(localTxBuffer + sizeof(FrameHeader), &pkt, sizeof(AckTelemPacket));
    uint16_t totalLen = sizeof(FrameHeader) + header->length;
    ProtocolUtils::appendCRC(localTxBuffer, totalLen);

    if (writeTransportPayload(port, localTxBuffer, totalLen + 2, fixedRoute, RadioTxAuxPolicy::SendAfterTimeout) == totalLen + 2)
    {
        countTxFrame(port);
    }
}

void sendCommandAck(
    uint8_t   seq,
    AckResult result,
    Stream   *port,
    bool      suppressAck,
    bool      useTelemAck,
    int16_t   shuttleStatusOverride)
{
    if (suppressAck)
        return;
    if (useTelemAck)
        sendTelemAck(seq, result, port, shuttleStatusOverride);
    else
        sendAck(seq, result, port);
}

uint8_t processPacket(FrameHeader *header, uint8_t *payload, Stream *replyPort)
{
    if (header->targetID != TARGET_ID_NONE && header->targetID != TARGET_ID_BROADCAST && header->targetID != shuttleNum)
    {
        DIAG_ONLY(
            if (replyPort == &SerialLora) linkDiag.radioRxDropTarget++;
            else if (replyPort == &SerialDisplay) linkDiag.displayRxDropTarget++;);

        LOG_RATE_LIMITED(
            LOG_WARN,
            2000,
            "Drop tgt src=%s exp=%u got=%u msg=%02X",
            (replyPort == &SerialLora) ? "radio" : "display",
            shuttleNum,
            header->targetID,
            header->msgID);
        return NO_NEW_CMD;
    }

    bool    requiresNoAck    = (header->msgID & MSG_FLAG_NO_ACK) != 0;
    bool    requiresTelemAck = (header->msgID & MSG_FLAG_REQ_TELEM) != 0;
    bool    useTelemAck      = requiresTelemAck && replyPort == &SerialLora;
    uint8_t realMsgID        = header->msgID & MSG_ID_MASK;

    if (realMsgID == MSG_REQ_HEARTBEAT)
    {
        if (replyPort == &SerialLora && manualRadioHoldActive)
        {
            refreshManualRadioHoldWatchdog(millis());
            touchManualSession();
        }
        uint32_t startUs = micros();
        sendTelemetryPacket(replyPort);
        countReplyTiming(replyPort, micros() - startUs);
        return NO_NEW_CMD;
    }
    else if (realMsgID == MSG_REQ_SENSORS)
    {
        uint32_t startUs = micros();
        sendSensorPacket(replyPort);
        countReplyTiming(replyPort, micros() - startUs);
        return NO_NEW_CMD;
    }
    else if (realMsgID == MSG_REQ_STATS)
    {
        uint32_t startUs = micros();
        sendStatsPacket(replyPort);
        countReplyTiming(replyPort, micros() - startUs);
        return NO_NEW_CMD;
    }
    else if (realMsgID == MSG_REQ_LINK_HEALTH)
    {
        uint32_t startUs = micros();
        sendLinkHealthPacket(replyPort);
        countReplyTiming(replyPort, micros() - startUs);
        return NO_NEW_CMD;
    }
    else if (realMsgID == MSG_REQ_AS5600_HEALTH)
    {
        uint32_t startUs = micros();
        sendAs5600HealthPacket(replyPort);
        countReplyTiming(replyPort, micros() - startUs);
        return NO_NEW_CMD;
    }
    else if (realMsgID == MSG_CMD_SIMPLE || realMsgID == MSG_CMD_WITH_ARG)
    {
        uint8_t reqCmd =
            (realMsgID == MSG_CMD_SIMPLE) ? ((SimpleCmdPacket *)payload)->cmdType : ((ParamCmdPacket *)payload)->cmdType;

        if (!isSupportedCommand(reqCmd))
        {
            sendCommandAck(header->seq, ACK_REJECTED, replyPort, requiresNoAck, useTelemAck);
            return NO_NEW_CMD;
        }

        if (reqCmd == CMD_SAVE_EEPROM)
        {
            pendingEepromSave = true;
            sendCommandAck(header->seq, ACK_OK, replyPort, requiresNoAck, useTelemAck);
            return NO_NEW_CMD;
        }
        if (reqCmd == CMD_GET_CONFIG)
        {
            sendCommandAck(header->seq, ACK_OK, replyPort, requiresNoAck, useTelemAck);
            return NO_NEW_CMD;
        }

        if (reqCmd == CMD_FIRMWARE_UPDATE)
        {
            if (replyPort != &SerialDisplay)
            {
                sendAck(header->seq, ACK_REJECTED, replyPort);
                return NO_NEW_CMD;
            }

            if (!isPhysicallyStationary())
            {
                sendAck(header->seq, ACK_BUSY, replyPort);
                return NO_NEW_CMD;
            }

            sendAck(header->seq, ACK_OK, replyPort);
            scheduleBootloaderEntry();
            return NO_NEW_CMD;
        }

        if (!isProvisionedShuttle() && !isUnprovisionedCommandAllowed(reqCmd))
        {
            if (reqCmd == CMD_MANUAL_MODE || isContinuousManualCommand(reqCmd) || isManualDistanceCommand(reqCmd) ||
                isLiftCommand(reqCmd))
            {
                makeLog(LOG_WARN, "Manual reject cmd=%02X reason=not_prov", reqCmd);
            }
            sendCommandAck(header->seq, ACK_BAD_ENVIRONMENT, replyPort, requiresNoAck, useTelemAck);
            return NO_NEW_CMD;
        }

        bool inChannel = digitalRead(CHANNEL);

        if (isErrorActive() && !isOverrideCommand(reqCmd))
        {
            if (reqCmd == CMD_MANUAL_MODE || isContinuousManualCommand(reqCmd) || isManualDistanceCommand(reqCmd) ||
                isLiftCommand(reqCmd))
            {
                makeLog(LOG_WARN, "Manual reject cmd=%02X reason=error", reqCmd);
            }
            sendCommandAck(header->seq, ACK_ERROR_STATE, replyPort, requiresNoAck, useTelemAck);
            return NO_NEW_CMD;
        }

        if (!inChannel && !isOutOfChannelExemptCommand(reqCmd))
        {
            if (reqCmd == CMD_MANUAL_MODE || isContinuousManualCommand(reqCmd) || isManualDistanceCommand(reqCmd) ||
                isLiftCommand(reqCmd))
            {
                makeLog(LOG_WARN, "Manual reject cmd=%02X reason=channel", reqCmd);
            }
            setWarning(WARN_NOT_IN_CHANNEL, 5000);
            sendCommandAck(header->seq, ACK_BAD_ENVIRONMENT, replyPort, requiresNoAck, useTelemAck);
            return NO_NEW_CMD;
        }

        if (canAcceptCommandNow(reqCmd, replyPort == &SerialLora))
        {
            if (realMsgID == MSG_CMD_WITH_ARG)
            {
                ParamCmdPacket *cmdArgs = (ParamCmdPacket *)payload;
                if (isManualDistanceCommand(reqCmd))
                    mooveDistance = cmdArgs->arg;
                else if (reqCmd == CMD_LONG_UNLOAD_QTY)
                    UPQuant = (uint8_t)cmdArgs->arg;
            }

            int16_t telemStateOverride = -1;
            if (useTelemAck && replyPort == &SerialLora)
            {
                telemStateOverride = (int16_t)predictTelemetryStateForAcceptedCommand(reqCmd, true);
            }
            sendCommandAck(header->seq, ACK_OK, replyPort, requiresNoAck, useTelemAck, telemStateOverride);
            return reqCmd;
        }
        else
        {
            if (reqCmd == CMD_MANUAL_MODE || isContinuousManualCommand(reqCmd) || isManualDistanceCommand(reqCmd) ||
                isLiftCommand(reqCmd))
            {
                makeLog(LOG_WARN, "Manual reject cmd=%02X reason=busy", reqCmd);
            }
            sendCommandAck(header->seq, ACK_BUSY, replyPort, requiresNoAck, useTelemAck);
            return NO_NEW_CMD;
        }
    }
    else if (realMsgID == MSG_SET_DATETIME)
    {
        DateTimePacket *dt = (DateTimePacket *)payload;
        if (!requiresNoAck)
            sendAck(header->seq, ACK_OK, replyPort);

        rtc.setTime(dt->hour, dt->minute, dt->second);
        rtc.setDate(getWeekDay(dt->day, dt->month, dt->year + 2000), dt->day, dt->month, dt->year);
        return NO_NEW_CMD;
    }
    else if (realMsgID == MSG_CONFIG_SET)
    {
        ConfigPacket *cfg = (ConfigPacket *)payload;
        if (!canApplyConfigNow())
        {
            if (!requiresNoAck)
                sendAck(header->seq, ACK_BUSY, replyPort);
            return NO_NEW_CMD;
        }

        switch (cfg->paramID)
        {
        case CFG_SHUTTLE_NUM:
        {
            if (!isValidProvisionedShuttleId(cfg->value))
            {
                if (!requiresNoAck)
                    sendAck(header->seq, ACK_REJECTED, replyPort);
                return NO_NEW_CMD;
            }
            uint8_t newId = (uint8_t)cfg->value;
            if (eepromData.shuttleNum == newId)
            {
                if (!requiresNoAck)
                    sendAck(header->seq, ACK_OK, replyPort);
                return NO_NEW_CMD;
            }
            const uint8_t              oldId       = shuttleNum;
            E22Radio::FixedRoute        ackRoute    = { 0, 0, 0 };
            const E22Radio::FixedRoute *ackRoutePtr = NULL;
            if (replyPort == &SerialLora)
            {
                const uint8_t oldReplyId = E22Radio::isValidNodeId(header->targetID) ? header->targetID : oldId;
                if (buildRemoteRouteForShuttleId(oldReplyId, &ackRoute))
                {
                    ackRoutePtr = &ackRoute;
                }
            }
            eepromData.shuttleNum = newId;
            shuttleNum            = newId;
            pendingEepromSave     = true;
            if (!requiresNoAck)
                sendAck(header->seq, ACK_OK, replyPort, ackRoutePtr);
            reapplyRadioConfigForShuttleId(newId, oldId);
            return NO_NEW_CMD;
        }
        case CFG_INTER_PALLET:
        {
            uint16_t value                  = (uint16_t)cfg->value;
            eepromData.interPalleteDistance = value;
            interPalleteDistance            = value;
            break;
        }
        case CFG_SHUTTLE_LEN:
        {
            uint16_t value           = (uint16_t)cfg->value;
            eepromData.shuttleLength = value;
            shuttleLength            = value;
            break;
        }
        case CFG_MAX_SPEED:
        {
            uint16_t value      = (uint16_t)cfg->value;
            eepromData.maxSpeed = value;
            maxSpeed            = value;
            break;
        }
        case CFG_MIN_BATT:
        {
            uint8_t value            = (uint8_t)cfg->value;
            eepromData.minBattCharge = value;
            minBattCharge            = value;
            break;
        }
        case CFG_WAIT_TIME:
        {
            int value           = (int)cfg->value;
            eepromData.waitTime = value;
            waitTime            = value;
            break;
        }
        case CFG_MPR_OFFSET:
        {
            int8_t value         = (int8_t)cfg->value;
            eepromData.mprOffset = value;
            mprOffset            = value;
            break;
        }
        case CFG_CHNL_OFFSET:
        {
            int8_t value          = (int8_t)cfg->value;
            eepromData.chnlOffset = value;
            chnlOffset            = value;
            break;
        }
        case CFG_FIFO_LIFO:
        {
            uint8_t value       = (uint8_t)cfg->value;
            eepromData.fifoLifo = value;
            fifoLifo            = value;
            break;
        }
        case CFG_REVERSE_MODE:
            if (eepromData.inverse != (uint8_t)cfg->value)
            {
                currentPosition = channelLength - currentPosition - 800;
            }
            eepromData.inverse = (uint8_t)cfg->value;
            inverse            = (uint8_t)cfg->value;
            break;
        default:
            if (!requiresNoAck)
                sendAck(header->seq, ACK_REJECTED, replyPort);
            return NO_NEW_CMD;
        }
        if (!requiresNoAck)
            sendAck(header->seq, ACK_OK, replyPort);
        return NO_NEW_CMD;
    }
    else if (realMsgID == MSG_CONFIG_SYNC_PUSH)
    {
        FullConfigPacket *fullCfg = (FullConfigPacket *)payload;
        if (!canApplyConfigNow())
        {
            if (!requiresNoAck)
                sendAck(header->seq, ACK_BUSY, replyPort);
            return NO_NEW_CMD;
        }

        if (!isValidProvisionedShuttleId(fullCfg->shuttleNumber))
        {
            if (!requiresNoAck)
                sendAck(header->seq, ACK_REJECTED, replyPort);
            return NO_NEW_CMD;
        }

        bool                        shuttleIdChanged = (eepromData.shuttleNum != fullCfg->shuttleNumber);
        const uint8_t               oldId            = shuttleNum;
        E22Radio::FixedRoute        ackRoute         = { 0, 0, 0 };
        const E22Radio::FixedRoute *ackRoutePtr      = NULL;
        if (shuttleIdChanged)
        {
            if (replyPort == &SerialLora)
            {
                const uint8_t oldReplyId = E22Radio::isValidNodeId(header->targetID) ? header->targetID : oldId;
                if (buildRemoteRouteForShuttleId(oldReplyId, &ackRoute))
                {
                    ackRoutePtr = &ackRoute;
                }
            }
        }

        eepromData.interPalleteDistance = fullCfg->interPallet;
        interPalleteDistance            = fullCfg->interPallet;
        eepromData.shuttleLength        = fullCfg->shuttleLen;
        shuttleLength                   = fullCfg->shuttleLen;
        eepromData.maxSpeed             = fullCfg->maxSpeed;
        maxSpeed                        = fullCfg->maxSpeed;
        eepromData.waitTime             = fullCfg->waitTime;
        waitTime                        = fullCfg->waitTime;
        eepromData.mprOffset            = (int8_t)fullCfg->mprOffset;
        mprOffset                       = (int8_t)fullCfg->mprOffset;
        eepromData.chnlOffset           = (int8_t)fullCfg->chnlOffset;
        chnlOffset                      = (int8_t)fullCfg->chnlOffset;
        eepromData.shuttleNum           = fullCfg->shuttleNumber;
        shuttleNum                      = fullCfg->shuttleNumber;
        eepromData.minBattCharge        = fullCfg->minBatt;
        minBattCharge                   = fullCfg->minBatt;
        eepromData.fifoLifo             = fullCfg->fifoLifo;
        fifoLifo                        = fullCfg->fifoLifo;
        eepromData.inverse              = fullCfg->reverseMode;
        inverse                         = fullCfg->reverseMode;

        if (shuttleIdChanged)
            pendingEepromSave = true;

        if (!requiresNoAck)
            sendAck(header->seq, ACK_OK, replyPort, ackRoutePtr);
        if (shuttleIdChanged)
            reapplyRadioConfigForShuttleId(fullCfg->shuttleNumber, oldId);
        return NO_NEW_CMD;
    }
    else if (realMsgID == MSG_CONFIG_SYNC_REQ)
    {
        uint32_t         startUs = micros();
        FullConfigPacket rep;
        rep.interPallet   = interPalleteDistance;
        rep.shuttleLen    = shuttleLength;
        rep.maxSpeed      = maxSpeed;
        rep.waitTime      = waitTime;
        rep.mprOffset     = mprOffset;
        rep.chnlOffset    = chnlOffset;
        rep.shuttleNumber = shuttleNum;
        rep.minBatt       = minBattCharge;
        rep.fifoLifo      = fifoLifo;
        rep.reverseMode   = inverse;

        uint8_t      localTxBuffer[sizeof(FrameHeader) + sizeof(FullConfigPacket) + 2];
        FrameHeader *repHeader = (FrameHeader *)localTxBuffer;
        repHeader->sync1       = PROTOCOL_SYNC_1_V2;
        repHeader->sync2       = PROTOCOL_SYNC_2_V2;
        repHeader->length      = sizeof(FullConfigPacket);
        repHeader->targetID    = TARGET_ID_NONE;
        static uint8_t repSeq  = 0;
        repHeader->seq         = repSeq++;
        repHeader->msgID       = MSG_CONFIG_SYNC_REP;

        memcpy(localTxBuffer + sizeof(FrameHeader), &rep, sizeof(FullConfigPacket));
        uint16_t totalLen = sizeof(FrameHeader) + repHeader->length;
        ProtocolUtils::appendCRC(localTxBuffer, totalLen);

        if (transportAvailableForWrite(replyPort) >= totalLen + 2 &&
            writeTransportPayload(replyPort, localTxBuffer, totalLen + 2, NULL) == totalLen + 2)
        {
            countTxFrame(replyPort);
            countReplyTiming(replyPort, micros() - startUs);
        }
        return NO_NEW_CMD;
    }
    else if (realMsgID == MSG_CONFIG_GET)
    {
        uint32_t      startUs = micros();
        ConfigPacket *req     = (ConfigPacket *)payload;
        ConfigPacket  rep;
        rep.paramID = req->paramID;
        rep.value   = 0;

        switch (req->paramID)
        {
        case CFG_SHUTTLE_NUM:
            rep.value = shuttleNum;
            break;
        case CFG_INTER_PALLET:
            rep.value = interPalleteDistance;
            break;
        case CFG_SHUTTLE_LEN:
            rep.value = shuttleLength;
            break;
        case CFG_MAX_SPEED:
            rep.value = maxSpeed;
            break;
        case CFG_MIN_BATT:
            rep.value = minBattCharge;
            break;
        case CFG_WAIT_TIME:
            rep.value = waitTime;
            break;
        case CFG_MPR_OFFSET:
            rep.value = mprOffset;
            break;
        case CFG_CHNL_OFFSET:
            rep.value = chnlOffset;
            break;
        case CFG_FIFO_LIFO:
            rep.value = fifoLifo;
            break;
        case CFG_REVERSE_MODE:
            rep.value = inverse;
            break;
        }

        uint8_t      localTxBuffer[sizeof(FrameHeader) + sizeof(ConfigPacket) + 2];
        FrameHeader *repHeader = (FrameHeader *)localTxBuffer;
        repHeader->sync1       = PROTOCOL_SYNC_1_V2;
        repHeader->sync2       = PROTOCOL_SYNC_2_V2;
        repHeader->length      = sizeof(ConfigPacket);
        repHeader->targetID    = TARGET_ID_NONE;
        static uint8_t repSeq  = 0;
        repHeader->seq         = repSeq++;
        repHeader->msgID       = MSG_CONFIG_REP;

        memcpy(localTxBuffer + sizeof(FrameHeader), &rep, sizeof(ConfigPacket));

        uint16_t totalLen = sizeof(FrameHeader) + repHeader->length;
        ProtocolUtils::appendCRC(localTxBuffer, totalLen);

        if (transportAvailableForWrite(replyPort) >= totalLen + 2 &&
            writeTransportPayload(replyPort, localTxBuffer, totalLen + 2, NULL) == totalLen + 2)
        {
            countTxFrame(replyPort);
            countReplyTiming(replyPort, micros() - startUs);
        }
        else
        {
            LOG_RATE_LIMITED(LOG_WARN, 1000, "Dropped Config Reply: TX Buffer Full");
        }

        return NO_NEW_CMD;
    }
    return NO_NEW_CMD;
}

uint8_t pollSerial(Stream &port, ProtocolParser &parser, bool isRadioPort)
{
    uint32_t now     = millis();
    uint8_t  lastCmd = NO_NEW_CMD;
    while (!pendingBootloaderEntry && port.available() > 0)
    {
        FrameHeader *header = parser.feed(port.read(), now);
        if (parser.crcError)
        {
            DIAG_ONLY(if (isRadioPort) linkDiag.radioRxCrcFail++; else linkDiag.displayRxCrcFail++;);
            parser.crcError = false;
            // LOG_RATE_LIMITED(LOG_WARN, 2000, "fail side=shuttle dir=rx reason=crc src=%s count=%lu",
            //                  isRadioPort ? "radio" : "display",
            //                  (unsigned long)(isRadioPort ? linkDiag.radioRxCrcFail : linkDiag.displayRxCrcFail));
        }
        if (header != nullptr)
        {
            DIAG_ONLY(if (isRadioPort) linkDiag.radioRxValid++; else linkDiag.displayRxValid++;);
            if (isRadioPort)
            {
                radioLastRxFrameMs = now;
                radioModuleResponded = true;
            }
            if (isRadioPort && radioAppendedRssiEnabled)
            {
                uint8_t rssiRaw = 0;
                e22Radio.readLastPacketRssiRaw(rssiRaw, E22Radio::kDefaultPacketRssiTimeoutMs);
            }
            uint8_t res = processPacket(header, (uint8_t *)header + sizeof(FrameHeader), &port);
            if (res != NO_NEW_CMD)
            {
                if (res == CMD_STOP || res == CMD_STOP_MANUAL)
                    return res;
                lastCmd = res;
            }
        }
    }
    return lastCmd;
}

// Выполнение команд с пульта ДУ
void run_Cmd()
{
    if (status == CMD_MOVE_LEFT_MAN)
    {
        send_Cmd();
        moove_Reverse();
        status = CMD_STOP;
        send_Cmd();
    }
    else if (status == CMD_MOVE_RIGHT_MAN)
    {
        send_Cmd();
        moove_Forward();
        status = CMD_STOP;
        send_Cmd();
    }
    else if (status == CMD_LIFT_UP)
    {
        send_Cmd();
        lifter_Up();
        status = CMD_STOP;
        send_Cmd();
    }
    else if (status == CMD_LIFT_DOWN)
    {
        send_Cmd();
        lifter_Down();
        status = CMD_STOP;
        send_Cmd();
    }
    else if (status == CMD_STOP || status == CMD_STOP_MANUAL)
    {
        if (motorStart)
            motor_Stop();
        status = CMD_STOP;
        send_Cmd();
    }
    else if (status == CMD_LOAD)
    {
        send_Cmd();
        lifter_Down();
        single_Load();
        status = CMD_STOP;
        send_Cmd();
    }
    else if (status == CMD_UNLOAD)
    {
        send_Cmd();
        lifter_Down();
        moove_Forward();
        unload_Pallete();
        status = CMD_MOVE_RIGHT_MAN;
        moove_Forward();
        status = CMD_STOP;
        send_Cmd();
    }
    else if (status == CMD_MOVE_DIST_R)
    {
        send_Cmd();
        moove_Distance_R(mooveDistance);
        status = CMD_STOP;
        send_Cmd();
    }
    else if (status == CMD_MOVE_DIST_F)
    {
        send_Cmd();
        moove_Distance_F(mooveDistance);
        status = CMD_STOP;
        send_Cmd();
    }
    else if (status == CMD_CALIBRATE)
    {
        send_Cmd();
        calibrate_Encoder_F();
        calibrate_Encoder_R();
        if (status != CMD_STOP)
            moove_Forward();
        status = CMD_STOP;
        send_Cmd();
    }
    else if (status == CMD_DEMO)
    {
        demo_Mode();
        firstPalletePosition = 0;
    }
    else if (status == CMD_COUNT_PALLETS)
    {
        pallete_Counting_F();
        status = CMD_STOP;
        send_Cmd();
        status = CMD_COUNT_PALLETS;
        makeLog(LOG_INFO, "Pallete count = %d", palleteCount);
        status = CMD_MOVE_RIGHT_MAN;
        moove_Forward();
        status = CMD_STOP;
        send_Cmd();
    }
    else if (status == CMD_SAVE_EEPROM)
    {
        saveEEPROMData(eepromData);
        status = CMD_STOP;
    }
    else if (status == CMD_COMPACT_F)
    {
        send_Cmd();
        pallete_Compacting_F();
        status = CMD_STOP;
        if (status != CMD_STOP)
            moove_Forward();
        send_Cmd();
    }
    else if (status == CMD_COMPACT_R)
    {
        send_Cmd();
        pallete_Compacting_R();
        firstPalletePosition = 0;
        status               = CMD_STOP;
        if (status != CMD_STOP)
            moove_Forward();
        send_Cmd();
    }
    else if (status == CMD_LONG_LOAD)
    {
        send_Cmd();
        lifter_Down();
        long_Load();
        if (status != CMD_STOP)
            moove_Forward();
        status = CMD_STOP;
        send_Cmd();
    }
    else if (status == CMD_LONG_UNLOAD)
    {
        send_Cmd();
        longWork = 1;
        lifter_Down();
        moove_Forward();
        long_Unload();
        longWork = 0;
        if ((status == CMD_STOP && distance[1] > 100) || isErrorActive())
            return;
        status = CMD_MOVE_RIGHT_MAN;
        moove_Forward();
        status = CMD_STOP;
        send_Cmd();
    }
    else if (status == CMD_LONG_UNLOAD_QTY)
    {
        send_Cmd();
        longWork = 1;
        lifter_Down();
        moove_Forward();
        status = CMD_LONG_UNLOAD_QTY;
        long_Unload(UPQuant);
        UPQuant  = 0;
        longWork = 0;
        if ((status == CMD_STOP && distance[1] > 100) || isErrorActive())
            return;
        status = CMD_MOVE_RIGHT_MAN;
        moove_Forward();
        status = CMD_STOP;
        send_Cmd();
    }
    else if (status == CMD_HOME)
    {
        moove_Forward();
        status = CMD_STOP;
        send_Cmd();
    }
}

// Ответы на запросы от пульта или сетевого клиента
void send_Cmd()
{
    sendTelemetryPacket(&SerialDisplay);
}

// Получение данных с датчиков обраружения паллет
void detect_Pallete()
{
    if (inverse)
    {
        detectPalleteF1 = digitalRead(DATCHIK_R1);
        detectPalleteF2 = digitalRead(DATCHIK_R2);
        detectPalleteR1 = digitalRead(DATCHIK_F1);
        detectPalleteR2 = digitalRead(DATCHIK_F2);
        delay(5);
        if (digitalRead(DATCHIK_R1) != detectPalleteF1)
        {
            delay(5);
            detectPalleteF1 = digitalRead(DATCHIK_R1);
        }
        if (digitalRead(DATCHIK_R2) != detectPalleteF2)
        {
            delay(5);
            detectPalleteF2 = digitalRead(DATCHIK_R2);
        }
        if (digitalRead(DATCHIK_F1) != detectPalleteR1)
        {
            delay(5);
            detectPalleteR1 = digitalRead(DATCHIK_F1);
        }
        if (digitalRead(DATCHIK_F2) != detectPalleteR2)
        {
            delay(5);
            detectPalleteR2 = digitalRead(DATCHIK_F2);
        }
    }
    else
    {
        detectPalleteF1 = digitalRead(DATCHIK_F1);
        detectPalleteF2 = digitalRead(DATCHIK_F2);
        detectPalleteR1 = digitalRead(DATCHIK_R1);
        detectPalleteR2 = digitalRead(DATCHIK_R2);
        delay(5);
        if (digitalRead(DATCHIK_F1) != detectPalleteF1)
        {
            delay(5);
            detectPalleteF1 = digitalRead(DATCHIK_F1);
        }
        if (digitalRead(DATCHIK_F2) != detectPalleteF2)
        {
            delay(5);
            detectPalleteF2 = digitalRead(DATCHIK_F2);
        }
        if (digitalRead(DATCHIK_R1) != detectPalleteR1)
        {
            delay(5);
            detectPalleteR1 = digitalRead(DATCHIK_R1);
        }
        if (digitalRead(DATCHIK_R2) != detectPalleteR2)
        {
            delay(5);
            detectPalleteR2 = digitalRead(DATCHIK_R2);
        }
    }
}

static ShuttleFault tofFaultForSensor(uint8_t sensorIndex)
{
    switch (sensorIndex)
    {
    case 0:
        return FAULT_TOF_CH_R;
    case 1:
        return FAULT_TOF_CH_F;
    case 2:
        return FAULT_TOF_PAL_R;
    case 3:
        return FAULT_TOF_PAL_F;
    default:
        return FAULT_NONE;
    }
}

static uint8_t tofSensorForDistanceSlot(uint8_t distanceSlot)
{
    if (!inverse)
    {
        return distanceSlot;
    }

    switch (distanceSlot)
    {
    case 0U:
        return 1U;
    case 1U:
        return 0U;
    case 2U:
        return 3U;
    case 3U:
        return 2U;
    default:
        return 0xFFU;
    }
}

static void latchTofMeasurementFault(uint8_t sensor, uint32_t now, const char *context)
{
    if (sensor >= 4U)
    {
        return;
    }

    const ShuttleFault fault             = tofFaultForSensor(sensor);
    const uint32_t     usableAge         = tofHealth[sensor].usableSampleAgeMs(now);
    const uint16_t     measurementStatus = tofHealth[sensor].lastMeasurementStatus();
    const uint16_t     signalStrength     = tofHealth[sensor].lastSignalStrength();
    if ((alertMan.getErrorCode() & (uint16_t)fault) == 0U)
    {
        tofHealth[sensor].markFaulted(now, TofFaultCause::Measurement);
        setFault(fault);
    }

    if (!tofFaultLogged[sensor])
    {
        makeReliableLog(
            LOG_ERROR,
            "TOF %s measurement unavailable %s age=%lu st=%u sig=%u",
            tofNameForSensor(sensor),
            context != nullptr ? context : "motion",
            (unsigned long)usableAge,
            measurementStatus,
            signalStrength);
        tofFaultLogged[sensor] = true;
    }
}

static bool ensureChannelTofReadyForMotion(bool forward, const char *context)
{
    if (sensorOff)
    {
        return true;
    }

    const uint8_t distanceSlot = forward ? 1U : 0U;
    const uint8_t sensor       = tofSensorForDistanceSlot(distanceSlot);
    const uint32_t now          = millis();
    if (sensor < 4U && tofHealth[sensor].measurementReady(now))
    {
        return true;
    }

    latchTofMeasurementFault(sensor, now, context);
    return false;
}

static void enforceActiveMotionTofSafety(uint32_t now)
{
    if (sensorOff || motorStart == 0U || motorReverse > 1U)
    {
        return;
    }

    const uint8_t distanceSlot = motorReverse == 0U ? 1U : 0U;
    const uint8_t sensor       = tofSensorForDistanceSlot(distanceSlot);
    if (sensor < 4U && tofHealth[sensor].outputValid(now))
    {
        return;
    }

    latchTofMeasurementFault(sensor, now, motorReverse == 0U ? "active_f" : "active_r");
    motor_Force_Stop();
}

static const char *tofNameForSensor(uint8_t sensorIndex)
{
    switch (sensorIndex)
    {
    case 0:
        return "ID1 Channel R";
    case 1:
        return "ID2 Channel F";
    case 2:
        return "ID3 Pallet R";
    case 3:
        return "ID4 Pallet F";
    default:
        return "unknown";
    }
}

static void incrementTofFailureCounter(uint8_t &counter)
{
    if (counter < 250)
    {
        counter++;
    }
}

static void resetTofBusVote()
{
    tofBusVoteMask         = 0U;
    tofBusVoteAs5600Failed = false;
}

static bool probeAs5600ForBusVote()
{
    if (!tofBusLinesHighNow())
    {
        return false;
    }
    return as5600Sensor.probeForBusVote();
}

static void recordTofBusVoteFailure(uint8_t sensor)
{
    if (sensor >= 4U || tofBusState != TofBusState::Ready || !tofBusLinesHighNow())
    {
        return;
    }

    tofBusVoteMask |= (uint8_t)(1U << sensor);
    if (tofBusVoteMask != 0x0FU)
    {
        return;
    }

    bool as5600FailedThisCall = false;
    if (!tofBusVoteAs5600Failed)
    {
        if (probeAs5600ForBusVote())
        {
            LOG_RATE_LIMITED(LOG_INFO, 30000U, "TOF bus_vote AS5600 ok; no recovery");
            resetTofBusVote();
            return;
        }
        tofBusVoteAs5600Failed = true;
        as5600FailedThisCall    = true;
        LOG_RATE_LIMITED(LOG_WARN, 5000U, "TOF bus_vote 4+AS5600 failed");
    }

    const uint32_t now = millis();
    if (tofRecoveryCooldownElapsed(now) && tofBusLinesHighNow())
    {
        if (!as5600FailedThisCall && probeAs5600ForBusVote())
        {
            resetTofBusVote();
            return;
        }
        (void)performTofWireReinit("bus_vote");
        resetTofBusVote();
    }
}
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
