Driadix/ShuttleController/Cntrl_V2/TOF_Sense.h

#ifndef _TOF_SENSE_H_
#define _TOF_SENSE_H_

#include "Arduino.h"
#include "Wire.h"

// Структура данных датчика
typedef struct
{
    uint8_t  id;              // ID датчика
    uint32_t system_time;     // Время с момента включения, мс
    uint32_t dis;             // Расстояние, мм
    uint16_t dis_status;      // Статус измерения: 0-invalid, 1-valid
    uint16_t signal_strength; // Сила сигнала
    uint8_t  range_precision; // Точность измерения, см (для TOFSense-F)
    uint8_t  interface_mode;  // Режим интерфейса: 0-UART, 1-CAN, 2-I/O, 3-I2C
    uint32_t uart_baudrate;   // Бодрейт UART
} TOF_Parameter;

// Базовый адрес I2C: 0x08 + ID
#define TOF_BASE_I2C_ADDR 0x08

// Размеры и адреса регистров
#define TOF_REGISTER_TOTAL_SIZE 48

#define TOF_ADDR_MODE 0x0c
#define TOF_SIZE_MODE 1

#define TOF_ADDR_ID 0x0d
#define TOF_SIZE_ID 1

#define TOF_ADDR_UART_BAUDRATE 0x10
#define TOF_SIZE_UART_BAUDRATE 4

#define TOF_ADDR_SYSTEM_TIME 0x20
#define TOF_SIZE_SYSTEM_TIME 4

#define TOF_ADDR_DIS 0x24
#define TOF_SIZE_DIS 4

#define TOF_ADDR_DIS_STATUS 0x28
#define TOF_SIZE_DIS_STATUS 2

#define TOF_ADDR_SIGNAL_STRENGTH 0x2a
#define TOF_SIZE_SIGNAL_STRENGTH 2

#define TOF_ADDR_RANGE_PRECISION 0x2c
#define TOF_SIZE_RANGE_PRECISION 1

// Размер блока данных для одного чтения измерения (system_time + distance + status + signal + precision)
#define TOF_MEASUREMENT_REG_START  0x20   // первый регистр данных измерения
#define TOF_MEASUREMENT_BLOCK_SIZE 13     // 0x20..0x2C включительно

enum TofI2cStatus : uint8_t
{
    TOF_I2C_OK = 0,
    TOF_I2C_INVALID_ARG,
    TOF_I2C_WIRE_ERROR,
    TOF_I2C_WIRE_TIMEOUT,
    TOF_I2C_SHORT_READ,
    TOF_I2C_ID_MISMATCH,
    TOF_I2C_NO_ACK,
    TOF_I2C_BUS_STUCK,
    // STM32duino Wire returns zero for a failed read phase without exposing
    // whether the cause was NACK, timeout, busy or an electrical disturbance.
    TOF_I2C_READ_FAILED_UNKNOWN
};

struct TofI2cDiagnostics
{
    TofI2cStatus status;
    uint8_t      address;
    uint8_t      reg;
    uint8_t      expected;
    uint8_t      received;
    uint8_t      wireStatus; // Raw Wire.endTransmission() status (0 = success).
};

// Функции
const char *TOF_I2C_Status_Name(TofI2cStatus status);
bool TOF_Inquire_I2C_Decoding_ByID(uint8_t id, TOF_Parameter *tof_data, TofI2cDiagnostics *diag = nullptr);
void IIC_Set_ID(uint8_t current_id, uint8_t new_id);
bool TOF_Is_Device_Present(uint8_t id, TofI2cDiagnostics *diag = nullptr);


#endif
