Driadix/ShuttleController/(commit log)

2025-02-27 init: add current shuttle contoller code
2026-02-19 feat: adjust sensors reports function to only update sensor values, move other logic to corresponding places
2026-02-20 Refactor protocol handling for concurrency safety and EEPROM efficiency
    - Isolated `sendLog` buffer: Replaced global `txBuffer` with a local `logBuffer` in `sendLog` to prevent race conditions with telemetry packets.
    - Updated `processPacket`:
    - Implemented `MSG_CONFIG_GET` handler to return current configuration parameters.
    - Added `CMD_SET_DATETIME` (202) handler with bit-packing logic for date/time sync.
    - Removed blocking `saveEEPROMData` call from `MSG_CONFIG_SET` to prevent flash wear and blocking behavior; configuration save now requires explicit `CMD_SAVE_EEPROM`.
    - Verified that `CMD_SAVE_EEPROM` (13) is correctly propagated to `run_Cmd` for execution.
2026-02-20 Fix CRC endianness and logging logic in STM32 controller
2026-02-24 feat: trying to replace display logic
    [ShuttleProtocol.h]
2026-02-27 Refactor Cntrl_V1_2_WS.ino to align with ShuttleProtocol V2
    - Route high-bandwidth telemetry to Serial1 (Display)
    - Swap parser associations for correct UART handling
    - Implement Protocol V2 sync bytes and scaled integer types
    - Replace legacy string-based commands with binary packet handlers
    - Secure sendLog with bounds checking and CRC
2026-03-02 Refactor serial packet parsing, fix FSM trap, and prevent buffer saturation
    [ShuttleProtocol.h]
2026-03-04 Refactor SystemYield polling and remove global txBuffer
    - Modify `SystemYield()` to drain both Serial1 and Serial2 hardware buffers independently every tick, prioritizing Radio over Display commands to prevent polling starvation.
    - Remove the unsafe global `txBuffer[512]`. Update `sendTelemetryPacket`, `sendSensorPacket`, `sendStatsPacket`, `sendAck`, and `processPacket` to use correctly sized, thread-safe local stack buffers (`localTxBuffer`), eliminating re-entrancy risks.
2026-03-04 feat: add eeprom save when error / check for motors off
2026-03-04 feat: add correct sizes for parser (tx/rx buf), add log asser
    [ShuttleProtocol.h]
2026-03-05 feat: adjust errors handling for sensors
2026-03-05 fix: make sure dead sensors are not cleared
2026-03-05 fix: adjust rx timeout
    [ShuttleProtocol.h]
2026-03-06 fix: adjust compilation errors
    [TOF_Sense.cpp]
2026-03-11 feat: adjust stm32 ota update logic and conditionals
2026-03-11 feat: add enhanced battery calculating
2026-03-11 feat: move bms read into dedicated library
2026-03-11 refactor: delete compatability old wrapper for battery reading
2026-03-12 feat: adjust battery limit protection handling
2026-03-13 feat: add additional pallete checks for sensors observability
2026-03-13 feat: adjust radio to fixed transmission mode
    [Cntrl_V2.ino]
2026-03-14 feat: добавить обработку дополнительных бамперов
2026-03-14 fix: adjust problem when sensors were dying for no reason
    [Cntrl_V2.ino]
2026-03-14 fix: adjust warn timings for battery
    [Cntrl_V2.ino]
2026-03-14 feat: make usage of alert manager for errors / warnings
    [AlertManager.h, Cntrl_V2.ino, ShuttleProtocol.h]
2026-03-17 feat: little adjustment to bumper error
    [Cntrl_V2.ino]
2026-03-17 feat: add reset in error / out of channel
    [Cntrl_V2.ino]
2026-03-17 logs: add additional log for crash
    [Cntrl_V2.ino]
2026-03-17 feat: adjust sensors auto recover to only self heal after error reset
    [Cntrl_V2.ino]
2026-03-18 Fix telemetry ACK state preview for radio commands
    [Cntrl_V2.ino]
2026-03-18 deploy: move code to arduino / platformio shared architecture
2026-03-18 feat: add correct forward declarations, adjust platformio config
    [Cntrl_V2.ino]
2026-03-19 fix: adjust tx power to 0.5w (tests on 1w bad)
    [Cntrl_V2.ino]
2026-03-19 fix: adjust distance check in channel
    [Cntrl_V2.ino]
2026-05-27 feat: enhance TOF sensor diagnostics and command handling
2026-05-28 feat: update pin assignments for E22 radio module
2026-05-29 feat: enhance logging framework with dynamic log size and improved frame handling
2026-05-29 feat: implement bootloader reset functionality and SRAM access management
    [Cntrl_V2.ino]
2026-05-29 feat: move bootloader reset request handling to the beginning of setup
    [Cntrl_V2.ino]
2026-05-29 Enhance E22Radio diagnostics and update ShuttleProtocol version
    - Added EnsureDiagnostics struct to E22Radio for improved diagnostic tracking.
    - Updated EnsureResult to include diagnostics information.
    - Modified various functions in E22Radio to utilize diagnostics, including baud rate tracking and error counting.
    - Changed ShuttleProtocol version from 2 to 3 and added ResetReasonFlags enum for reset reasons.
    - Updated StatsPacket to include detailed reset counts and last reset flags.
    - Improved I2C communication in TOF_Sense with error handling and return values for read operations.
    - Updated function signatures in TOF_Sense to return success status.
    [Cntrl_V2.ino, E22Radio.hpp, ShuttleProtocol.h, TOF_Sense.cpp, TOF_Sense.h]
2026-06-02 feat: enhance TOF I2C diagnostics with detailed status reporting and error handling
    [Cntrl_V2.ino, TOF_Sense.cpp, TOF_Sense.h]
2026-07-03 feat: adjust tof sensors lib, add docs
2026-07-09 feat: enhance TOF device presence check with diagnostic data
2026-07-09 feat: enhance tof lib for id repres, strenghten logs for i2c slaves
2026-07-09 reafactor: get rid of 100khz i2c fallback
2026-07-10 feat: adjust i2c tof handling
2026-07-10 feat: add controller PCB
    [ControllerV6-B_Cu.gbr, ControllerV6-B_Mask.gbr, ControllerV6-B_Paste.gbr, ControllerV6-B_Silkscreen.gbr, ControllerV6-Edge_Cuts.gbr, ControllerV6-F_Cu.gbr, ControllerV6-F_Mask.gbr, ControllerV6-F_Paste.gbr]
2026-07-10 feat: harden tof sensors
2026-07-14 feat: update TOF sensor error handling and diagnostics
    [Cntrl_V2.ino, TOF_Sense.cpp, TOF_Sense.h]
2026-07-14 feat: refactor TOF I2C diagnostics to use Wire status and simplify error handling
    [Cntrl_V2.ino, TOF_Sense.cpp, TOF_Sense.h]
2026-07-16 docs: add corresponding to sensor docs
2026-07-16 Refactor ToF driver and add BmsDdA5 scheduler tests
    - Updated TOF_Sense.cpp to improve error handling for I2C read failures.
    - Removed unused IIC_Change_Mode_To_UART function and related constant.
    - Introduced TofBusMonitor.h to manage bus states.
    - Added BmsDdA5SchedulerTests.cpp to implement unit tests for BmsDdA5 client functionality, including startup retries and basic information intervals.
    [BmsDdA5.hpp, BmsDdA5FirmwareAdapter.hpp, Cntrl_V2.ino, TOF_Sense.cpp, TOF_Sense.h]
2026-07-16 fix: adjust false stale because of e22 reconfiguration
    [Cntrl_V2.ino]
2026-07-17 feat: move as5600 into separate packet, add dedicated error and health packet
    [As5600HealthMonitor.h, As5600Sensor.cpp, As5600Sensor.h, Cntrl_V2.ino, ShuttleProtocol.h]
2026-07-17 feat: soften as5600 handling with correct mask
    [As5600Sensor.cpp, As5600Sensor.h]
